Tokoro0917/KOGUMA.MkIIl/README.md

# KOGUMA MkIIl

STM32F446RE(STM32CubeIDE)をベースにしたマイクロマウス(クラシック、迷路探索ロボット)のファームウェア。

- 大会までの予定とやることは`TODO.md`
- 詳しい設計・調べたこと・変更の記録は`docs/`(下の「資料」)

## 目次

1. [動かし方](#動かし方)
2. [大会での流れ](#大会での流れ)
3. [モード](#モード)
4. [出力とビューア](#出力とビューア)
5. [よく変える設定](#よく変える設定)
6. [実機での確認状況](#実機での確認状況)
7. [壁センサ・横壁制御・壁切れ](#壁センサ横壁制御壁切れ)
8. [テストとCI](#テストとci)
9. [ビルド・ハードウェア・ディレクトリ](#ビルドハードウェアディレクトリ)
10. [資料](#資料)

## 動かし方

ロータリーエンコーダの`Encorder_mode_out()`(モード)と`Encorder_number_out()`(ナンバー)の組み合わせで動作を選ぶ。どちらも0〜15。

1. モードとナンバーを選ぶ
2. **左前センサに手をかざす**(`Sensor_Enter()`、FLが1400超)
3. ブザーのあと**左右の横センサに手をかざす**(`Sensor_Start()`、L+Rが2000超)とスタート

走行が終わると`Encorder_count_reset()`でモード0・No.0に戻る。迷路とログはRAMにしか残らないので、**出力するまで電源を切らない**。

## 大会での流れ

1. **会場に着いたら感度合わせ**(モード3 No.5): 区画中心で値を測る → 出た行(`WallDist_Scale`と各しきい値)を書き写す → ビルドし直す(手順は「会場ごとの感度合わせ」)
2. 探索(モード0)
3. 最短走行(モード1)
4. 走らせるたびに、電源を切らずに出力(モード4 No.7)し、ビューアで保存する(迷路とログはRAMにしか残らない。リセットや電源断で消える)

気をつけること:

- `Core/Inc/Define.h`の`MAZE_GOOL_X/Y`は標準ゴール(迷路中央2×2、`MAZE_SIZE/2-1`)。ベンチテストでスタート近くにゴールを置きたいときだけ一時的に書き換え、**書き換えたままコミットしないこと。** 行き止まり潰しのゴール保護もこの定数から導出している。出力(モード4 No.7)の迷路の図の`G`でゴールの位置を確認できる。
- `Move.c`の`Short_Dijkstra_Move2000()`終端の旋回角度(180°→270°)の調整は、手元で作業中ならリポジトリには未反映。
- ゴールは1マス(`MAZE_GOOL_X/Y`、16×16で(7,7))を目指して探索する。標準の中央2×2のゴールなら必ず入れるが、そのマスに行けない迷路では探索の逃げ道がなく、前の壁に向かって進んでしまう(全面探索には「どこにも行けなければスタートへ戻る」逃げ道がある)。

## モード

| モード | 内容 | 番号 |
|---|---|---|
| 0 | **大会用: 探索走行**(往復・片道・全面探索・未知壁探索・探索後の最短) | No.1〜10 |
| 1 | **最短走行**(BFS / ダイクストラ、コーナー2000・2400・ターンごと) | No.1〜11 |
| 2 | サーキット(未実装) | |
| 3 | デバッグ: 固定速度の最短(No.1〜3)、距離の表を作る(No.4)、会場ごとの感度合わせ(No.5)、壁切れのテスト(No.6〜9) | No.1〜9 |
| 4 | 基本調整: センサ表示、直進、旋回、**出力(No.7)**、最初のターンの調整など | No.0〜14 |
| 5〜9 | 速度別のターン単体テスト(1.0 / 2.0 / 2.4 / 2.7 / 3.0 m/s) | No.0〜7 |
| 10 | ターンごとの通過速度のターン単体テスト | No.1〜7 |

表にない番号(モード0 No.0・No.11〜15、モード1 No.0・No.12〜15、モード2、モード3 No.0・No.10〜15、モード4 No.15、モード10 No.0・No.8〜15、モード11〜15など)は何もしない。

### モード0: 大会用(探索走行)

往路(スタート→ゴール)のあと、片道ならゴールで止まり、それ以外はスタートへ戻る。区間の終わりごとに`Maze_Save()`する。No.8〜10はスタートに戻ったあと2秒待って最短走行(モード1 No.5と同じ: ダイクストラ、コーナー2000、直線6000mm/s、加速20000)まで走る。中身は`main.c`の`Maze_Search(flags)`で、番号ごとに`SEARCH_*`の組み合わせを指定している。

| No | 走り方 | 復路 | `SEARCH_*` |
|---|---|---|---|
| 0 | (何もしない) | | |
| 1 | スラローム探索(500mm/s、吸引なし) | 往復 | `SLALOM` |
| 2 | スラローム探索 | 往復、復路で**エセ全面探索** | `SLALOM \| ALL` |
| 3 | スラローム探索 | **片道**(ゴールで止まる) | `SLALOM \| ONEWAY` |
| 4 | 吸引探索(1000mm/s、吸引あり) | 往復 | `SUCTION` |
| 5 | 吸引探索 | 往復、復路で**エセ全面探索** | `SUCTION \| ALL` |
| 6 | 吸引探索 | ゴール後に**ダイクストラ誘導の未知壁探索**、終わったらスタートへ | `SUCTION \| DIJKSTRA` |
| 7 | 吸引探索+**既知区間加速** | No.6と同じ | `SUCTION \| DIJKSTRA \| KNOWN` |
| 8 | スラローム探索 | 往復 → **最短** | `SLALOM \| SHORTEST` |
| 9 | 吸引探索 | 往復 → **最短** | `SUCTION \| SHORTEST` |
| 10 | 吸引探索+**既知区間加速** | No.6と同じ → **最短** | `SUCTION \| DIJKSTRA \| KNOWN \| SHORTEST` |

片道(No.3)はゴール区画に入ったところで、Uターンのときと同じ減速(70mm)で止まる。

既知区間加速(`Robot_Maze_Pass_Action()`)は、次の区画が探索済みなら、未探索の区画の手前までを`Known_Pass_Generation()`でまとめて経路にし、直線を最大4000mm/sで走る。

ダイクストラ誘導(No.6/No.7/No.10)は往路でゴールに着いたあと、スタート→ゴールのダイクストラ経路上に残っている未確認の壁を、今いる位置から直接見に行く(`Maze_Unknown_Wall_Scan()`)。経路の計算は、未確認の壁を「通れる」として行う。計算し直すのは、ゴールに着いた直後、Uターンしたとき、**見に行った壁が実際にあった(経路がふさがれた)とき**だけで、どれも**機体が区画の中央で止まっているあいだに**計算する。ゴールに着いた直後と、壁があったときは、次の区画の中央で止まり、前に壁があれば壁合わせをしてから計算し、進む向きを決めて発進する(`Robot_Maze_Stop_And_Go()`)。Uターンでは止まっているあいだに計算し(`G_Stop_Hook`)、行き止まりでなければ計算した結果で進む向きを決め直す。見に行った壁がなかった(通れた)ときは、ダイクストラは計算し直さず、止まらずに同じ経路で次の未確認の壁を探す。経路上の未知壁がなくなったらスタートへ帰る。このとき、その経路の壁はすべて確認済みなので、それが本当の最短経路になる。

エセ全面探索(`Maze_Unkown_ALL_ModeSet()`)が有効なのは**No.2・No.5だけ**。したがって**行き止まり潰しが走行に影響するのもこの2つだけ**(`Maze_DeadEnd_Fill()`自体は常に計算されるが、結果を使う`Maze_Gool_Setting()`の分岐がALL_MODE時にしか通らないため)。

探索のアルゴリズム(BFS・ダイクストラ、行き止まり潰し)は`docs/maze_algorithm.md`。

### モード1: 最短走行

`Short_*_Move*(MAX, AC)`の`MAX`が直線区間の最高速度、`AC`が加速度。関数名の数字はコーナー通過速度。直線最高速はどれも6000mm/s。中身は`main.c`の`Maze_Shortest_Run()`。斜めの直線の加速度は番号ごとの`ac_nn`(`G_Short_AC_NANAME`)で決める。

| No | 経路生成 | コーナー | 加速度 | 斜めの加速度 | 関数 |
|---|---|---|---|---|---|
| 0 | (何もしない) | | | | |
| 1 | BFS | 2000 | 15000 | 10000 | `Short_NANAME_Move2000` |
| 2 | BFS | 2000 | 20000 | 15000 | `Short_NANAME_Move2000` |
| 3 | BFS | 2400 | 20000 | 15000 | `Short_NANAME_Move2400` |
| 4 | ダイクストラ | 2000 | 15000 | 10000 | `Short_Dijkstra_Move2000` |
| 5 | ダイクストラ | 2000 | 20000 | 15000 | `Short_Dijkstra_Move2000` |
| 6 | ダイクストラ | 2000 | 23000 | 18000 | `Short_Dijkstra_Move2000` |
| 7 | ダイクストラ | 2000 | 25000 | 20000 | `Short_Dijkstra_Move2000` |
| 8 | ダイクストラ | 2400 | 20000 | 15000 | `Short_Dijkstra_Move2400` |
| 9 | ダイクストラ | 2400 | 23000 | 18000 | `Short_Dijkstra_Move2400` |
| 10 | BFS | ターンごと(`docs/turnv_design.md`) | 20000 | 15000 | `Short_NANAME_MoveTurnV` |
| 11 | ダイクストラ | ターンごと(`docs/turnv_design.md`) | 20000 | 15000 | `Short_Dijkstra_MoveTurnV` |

`main.c`の`Short_WallCut_Pillar`を1にすると、最短走行(モード1、モード0 No.8〜10の探索後の最短)の壁切れを柱で見る(「壁切れ」)。既定は0。

No.10・No.11(ターンごとの通過速度)の考え方と速度の決め方は`docs/turnv_design.md`。

No.2とNo.5はパラメータが同一で、BFS経路とダイクストラ経路の比較用になっている。

`Short_Dijkstra_Move2400`は、経路の作り方だけをダイクストラに切り替えて`Short_NANAME_Move2400`と同じ動きで走る(命令列の形はBFSと同じ)。`Short_Dijkstra_Move2000`は旋回のパラメータが`Short_NANAME_Move2000`とは別に調整されている。

コーナー2700(`Short_NANAME_Move2700`)の関数は残してあるが、今はどの番号からも呼んでいない(実機で走れていない)。

### モード3: デバッグ

直線最高速をコーナー速度と同値にして、区間ごとの加減速を実質なくしたもの。

| No | コーナー | 直線最高速 | 加速度 |
|---|---|---|---|
| 1 | 2000 | 2000 | 20000 |
| 2 | 2400 | 2400 | 20000 |
| 3 | 2700 | 2700 | 20000 |
| 4 | 壁センサの距離の表を作る(「距離の表を作り直すとき」) | | |
| 5 | 会場ごとの感度合わせ(区画中心、「会場ごとの感度合わせ」) | | |
| 6〜9 | 壁切れの位置のテスト(500 / 1000 / 2000 / 2400。「壁切れ」、結果は出力 モード4 No.7) | | |

### モード4: 基本調整

| No | 内容 |
|---|---|
| 0 | センサ値・電圧・ジャイロのprintf表示 |
| 1 | 直進テスト(タイヤ径の測定用。吸引70、最大1000・加速度5000で1440mm。2026-10-09 までは吸引35・最大3000・加速度10000) |
| 2 | その場180°旋回テスト |
| 3 | スラロームテスト |
| 4 | 斜め走行テスト |
| 5 | 吸引ON(duty 90)。左前センサに手をかざすと止まる |
| 6 | 壁合わせ |
| 7 | **出力**。RAMに残っているデータを全部出す(迷路、壁切れのログ、走行ログ。下の「出力とビューア」) |
| 8 | 直進テスト(吸引35、最大3000・加速度10000で1440mm)を、横壁制御のセンサ値版(`Kp`/`Kd`)で走る。距離版との比較・切り戻し用 |
| 9 | 最短走行の最初のターンの調整: 右大回り90を1480で(スタート位置から、ターン後は2400へ加速して1区画で止まる) |
| 10 | 同 右斜め入り45を1110で(ターン後は斜めに2区間で止まる) |
| 11 | 同 右斜め入り135を1400で |
| 12〜14 | No.9〜11 と同じターンを、加速しながら曲がる方式で(`G_First_Turn_Accel = 1`) |

### モード5〜9: 速度別のターン単体テスト

モード5=1.0, 6=2.0, 7=2.4, 8=2.7, 9=3.0 m/s。No.1〜7は共通で 1=90°, 2=180°, 3=in45°, 4=in135°, 5=out45°, 6=out135°, 7=V90°。

| モード | No.0 | No.1〜7 |
|---|---|---|
| 5 (1.0m/s) | 90°小回り | 実装済み |
| 6 (2.0m/s) | 直進(吸引51、最大6000・加速度40000で1080mm) | 2000のターン単体(`G_Turn2000`、左旋回、壁切れなし。最短の2000と同じ値) |
| 7 (2.4m/s) | 空 | 実装済み |
| 8 (2.7m/s) | 空 | 実装済み |
| 9 (3.0m/s) | 空 | **No.1のみ実装**、2〜7は空 |

「空」はセンサ待機だけで何も走らせない分岐。

### モード10: ターンごとの通過速度のターン単体テスト

`Short_NANAME_MoveTurnV`の`TurnV_Table`の速度とパラメータで、ターンを1つだけ走る(`Move.c`の`TurnV_Test()`、左旋回)。モード7と同じく壁切れを使わず、前距離・後距離は固定の距離で走る。表の`v`や`offset_st`/`offset_end`を変えたら、ここで1つずつ確かめる。

| No | ターン |
|---|---|
| 1 | 大回り90 |
| 2 | 大回り180 |
| 3 | 斜め入り45 |
| 4 | 斜め入り135 |
| 5 | 斜め出45(斜め入り45で斜めに入り、斜めの直線1区間で表の速度に合わせてから) |
| 6 | 斜め出135(同上) |
| 7 | V90(同上) |

## 出力とビューア

### 出力(モード4 No.7)

RAMに残っているデータを全部、迷路 → 壁切れのログ → 走行ログ の順に出す(ないものは出さない。最後に`#DONE`)。出力のモードはこれひとつ(感度合わせ・距離の表は、そのモードで出し続ける)。

| データ | いつ残るか | 中身 |
|---|---|---|
| 迷路(`MAZE`) | 探索の区間の終わりごと(`Maze_Save()`) | 壁・見た壁、最短走行の命令列(BFS・ダイクストラ)、計算時間。詳しくは`docs/maze_algorithm.md`の「迷路の出力」 |
| 壁切れのログ(`EDGE`) | 最短走行のあいだ、壁切れのテスト(モード3 No.6〜9) | 柱の端、前距離・後距離の始めと終わり、テストでは1mmごとの横センサの値。詳しくは`docs/pillar_cut_design.md`の付録 |
| 走行ログ(`LOG`) | 最短走行(4msおき・8秒、走り始めから)、ターンや直進のテスト(1msおき・2秒) | 走った距離、速度、角速度、角度、横の壁までの距離、横壁制御、横センサ、電圧、電池、動作。詳しくは`docs/log_design.md` |

### ビューア(`tools/viewer.html`)

ロボットのUART出力を、そのままグラフ・表・迷路にするページ。Tera Termはいらない。ネットも使わない(外から何も読み込まないので、会場でも使える)。

1. ロボットをUSBシリアルでつなぎ、`tools/viewer.html`をWindowsのChrome(かEdge)で開く(ダブルクリック)。Tera Termは閉じておく(同じCOMポートは1つしか開けない)
2. 「接続」を押してCOMポートを選ぶ(115200)。届いた文字は下のコンソールに出る
3. 「保存先フォルダ」でリポジトリの`logs/`を選ぶと、届いたデータを1つずつファイル(`日時_種類.txt`)にして自動で保存する。そのファイルをコミットすれば、Claudeは元のデータをそのまま読める
4. ロボットでモード4 No.7(出力)を選ぶと、残っているデータ(迷路・壁切れ・走行ログ)が全部届き、左の一覧に種類ごとに増えて、自動で表示される

| ロボットの出力 | 表示 |
|---|---|
| 走行ログ | 速度・角速度・角度・横の壁までの距離・横壁制御(出力・P項・D項)・誤差・使った壁・横センサ・電圧・電池のグラフ。動作(直線・前距離・ターン・後距離・止まる)で背景を色分けする。横軸は時間か走った距離を選べる。ドラッグで拡大(全部のグラフがそろう)、ダブルクリックか Esc か「拡大を元に戻す」ボタンで元に戻す、指すとその時刻の値と動作。表示している範囲の平均・標準偏差・最小・最大の表(動作で絞れる)。一覧で別のログに印を付けると破線で重ねる |
| 壁切れのテスト(モード3 No.6〜9で走らせたあと) | 横センサの値と距離のグラフ(1mmごと。区画の境目と見つけた柱の端を重ねる。柱のところで値がどう下がるか、`Edge_Min_High`をいくつにするかを見る)。左右・種類ごとの c-border(境目の推定 − 区画の境目)の平均・標準偏差。そのページで読んだテスト全部を速度ごとにまとめた表と、c-border と速度の点のグラフ(左右別)、書き写す`Edge_Off`の行 |
| 最短走行の壁切れ | 柱の端・前距離・後距離・従来の壁切れを距離の軸に並べた図。前距離をどれだけ直したか、どの推定を使ったかの表。後距離が X より早く終わったかの表 |
| 迷路 | 迷路の図(見ていない壁は点線)と、経路の命令列・計算時間 |
| 感度合わせ(モード3 No.5) | 書き写す行(コピーのボタン付き)。測っているあいだ約1秒ごとに届くが、一覧には増やさず、いちばん新しい値に置き換える(5秒あくと新しい測定)。自動では保存しない(残したいときは「ファイルに保存」) |
| センサの値(モード4 No.0、モード3 No.4) | 一覧のいちばん上の「センサの値(そのまま)」。直近10秒を流れるグラフ(FL・L・R・FR、モード4 No.0は電池と角速度、モード3 No.4は表で変換した距離も)と、今の値。「止める」で止めて見られる。直近60秒をCSVで保存できる。モード4 No.0の値は10回の移動平均(`g_sensor_av10`)なので、1回だけの落ち込みは見えにくい |

- 保存したファイルや、Tera Termのログは「ファイルを開く」かドラッグで読み込める(`tools/sample_output.txt`はロボットなしで見た目を確かめる用の例)
- 「ぜんぶ保存」は、ページを開いてから届いた文字を1つのファイルにする(長くなったら最後の約10MB、約14分ぶんだけ)
- 出力の形: どれも`#BEGIN 種類 項目=値 ...`で始まり`#END 種類`で終わる(`LOG`・`EDGE`・`MAZE`・`CENTER`)。`LOG`は次の行が列名なので、列を増やしてもビューアは直さなくてよい
- ダブルクリックで開いた(`file://`)ままで、USBシリアルもフォルダへの保存も使える(Chromiumで確かめた)。もし使えなければ、`tools`で`python -m http.server`を実行して`http://localhost:8000/viewer.html`を開く

## よく変える設定

| 設定 | 場所 | 今の値 | 内容 |
|---|---|---|---|
| `Short_WallCut_Pillar` | `main.c` | 0 | 1で、最短走行の壁切れを柱で見る(「壁切れ」) |
| `ac_nn` | `main.c`(モード1の番号ごと) | 上の表 | 最短走行の斜めの直線の加速度(0なら直線の加速度-5000) |
| `G_WallCtrl_Use_mm` | `Wallsensor.c` | 1 | 横壁制御。1=距離版、0=センサ値版 |
| `Kp_mm` / `Kd_mm` | `Wallsensor.c` | 0.30 / 0.06 | 距離版の横壁制御のゲイン(センサ値版の`Kp`=0.05 / `Kd`=0.01と同じ効き) |
| `WallDist_Scale` | `WallDistance.c` | 0.99, 0.96, 1.00, 1.02 | 会場ごとの倍率(FL, R, L, FR)。モード3 No.5で測る |
| `Cut_L` / `Cut_R`(`_NA`) | `motor.c` | 80(斜めは150) | 壁切れの閾値 |
| `G_WallCut_Fast` | `motor.c` | 0 | 1で、壁ありの壁切れを遅れの少ない値(3回の中央値)で見る。壁切れの位置が変わるので前距離・後距離を合わせ直す |
| 柱の壁切れの値: `Edge_Off` / `Edge_Tan` / `Edge_Win` | `Wallsensor.c` / `motor.c` | 84 / 1.07 / 20 | 柱の端から境目までの距離(左右・種類ごと)、横のずれの補正、前距離で推定を探す範囲。モード3 No.6〜9で実測して直す |
| `TIREDIAMETER` | `Define.h` | 23.1 | タイヤ径[mm]。モード4 No.1で測る |
| `G_Turn2000` | `Move.c` | | 2000のターンの前距離・角度・角速度・角加速度・後距離(モード6で調整) |
| `TurnV_Table` | `Move.c` | | ターンごとの通過速度(モード10で調整) |
| `G_First_Turn` / `G_First_Turn_Accel` | `Move.c` | / 0 | 最短の最初のターンの値と、加速しながら曲がる方式を使うか(モード4 No.9〜14) |
| `KNOWN_PASS_BIG_TURN` | `Maze.c` | 0 | 探索の既知区間加速で大回りを使うか |
| `G_Log_Div` | `LOG.c` | 1(最短は4) | 走行ログを何msおきに取るか(`main.c`の最短走行で4にする) |
| `MAZE_SIZE` | `Define.h` | 16 | 迷路のサイズ(16 / 32。32はRAMが足りない、`docs/maze_algorithm.md`) |

## 実機での確認状況

2026-10-12時点。2026-10-08 以降の変更の多くは、実機で未確認。

| 項目 | 結果 |
|---|---|
| STM32CubeIDEでのビルド | 2026-10-07 まで OK。それ以降(モード1 No.10・No.11、モード10、柱の壁切れ、ビューア向けの出力)は未確認。ARMのgccではビルドとリンクが通る |
| モード4 No.0(センサ・電圧・ジャイロ) | OK |
| モード0 No.1〜10 | OK(2026-10-06)。No.4はゴール後のUターンで急に前進していたが、Uターンの位置合わせの修正後にOK |
| モード1 No.1〜9 | OK(2026-10-07)。2026-10-09 にダイクストラ2000のターンの値・2000の走り出し・タイヤ径を変えたあとは未確認 |
| 最短走行の走り出し(最初がターン) | 2026-10-08 に最初のターン3つを調整し(モード4 No.9〜11)、2000・2400とも走ることを確認 |
| 横壁制御の距離版(既定) | 探索・最短走行とも問題なし(2026-10-07)。2026-10-10 のゲイン・判定の変更のあとは未確認 |
| 迷路の出力 | OK(以前のモード3 No.0。PCでも同じ命令列になり壁に当たらない)。モード4 No.7 にまとめたあとは未確認 |
| モード3 No.5(会場ごとの感度合わせ) | OK。測った倍率を`WallDist_Scale`に入れた |
| モード1 No.10・No.11、モード10(ターンごとの通過速度) | 未確認 |
| モード3 No.4(距離の表) | 未確認 |
| 柱の壁切れ、モード3 No.6〜9、出力(モード4 No.7)、ビューア | 未確認(2026-10-12 に追加) |

## 壁センサ・横壁制御・壁切れ

### 壁センサの距離変換(`Core/Src/WallDistance.c`)

壁センサの値は距離に比例しない(近いほど急に大きくなる)。センサ値の差をそのまま制御に使うと、壁に近いときはゲインが効きすぎ、遠いときは効かなくなる。また左右のセンサで感度が違うため、`(L - 220) - (R - 200)`は単位の違う数どうしの引き算になる。`WallDist_mm(sensor, value)`はセンサ値を距離[mm]に変換する(表引き+直線補間)。

距離の定義: 横センサは機体の中心線から横壁の表面まで、前センサは機体の中心から前壁の表面まで。区画中心ではどちらも84mm。

**横(L/R)は実測値**(2026-10-06)。機体の側面を反対側の壁につけ、壁の板(12mm)を n 枚はさんで、測る側の壁までを 133 − 12n mm(n = 0〜8、37〜133mm)にして測った(区画の内のり168mm、機体の幅70mm)。区画中心付近(85mm)で L=237、R=201。**前(FL/FR)も実測値**。お尻を後ろの壁につけ、板を n 枚はさんで前の壁までを 108 − 12n mm(n = -8〜4、60〜204mm。n が負はお尻を後ろの壁から離した)にして測った(全長120mm、中心からお尻まで60mm)。区画中心(84mm)で FL=645、FR=627。60mmより近い点はまだ測っていない(表の範囲外は端の値になる)。

#### 距離の表を作り直すとき(モード3 No.4)

1. モード3 No.4を選び、前センサに手をかざしてから横センサに手をかざしてスタートする
2. 約0.2秒ごとに`CAL,FL,L,R,FR,FL_mm,L_mm,R_mm,FR_mm`の形式でシリアル出力される(センサ値は100回平均、`_mm`は現在の表で変換した距離)
3. 横センサ: 機体を横にずらし、壁までの距離を44, 54, …, 124mmに合わせてL/Rの値を記録する
4. 前センサ: 前壁までの距離を34, 44, …, 174mmに合わせてFL/FRの値を記録する
5. `WallDistance.c`の表に書き写し、`test/test_walldist.c`を実行して表の並びが正しいか確認する
6. もう一度モード3 No.4で、`_mm`の列が実際の距離と一致するか確認する

手で機体を動かすとエンコーダのモード選択が変わるが、キャリブレーション中はループの中にいるので影響しない。終了はリセット。

#### 会場ごとの感度合わせ(モード3 No.5)

会場では壁の反射の強さ(塗装)が変わり、センサ値が全部の距離でほぼ同じ割合で変わる。表は作り直さず、区画中心で1回測った倍率で合わせる。

1. モード3 No.5を選び、前センサに手をかざしてから横センサに手をかざしてスタートする
2. 機体を区画中心に置き、前・左・右に壁がある状態にする(スタート区画なら、後ろの壁のほうを向けて置く)
3. 約1秒ごとに、500回平均した値と、書き写す行がシリアルに出る
   - `WallDistance.c`の`WallDist_Scale`(倍率 = 測った値 / 表の区画中心の値。距離変換はセンサ値をこれで割ってから表を引く)
   - `Wallsensor.c`の`Wall_L`/`Wall_R`/`FlontWall_Distance`(区画中心の値そのもの)と`Wall_threshold`
   - `Move.c`の`ALIGN_FRONT_MIN`、`motor.c`の`Cut_R`/`Cut_L`/`Cut_R_NA`/`Cut_L_NA`
4. 出た行を手で書き写してビルドし直す。終了はリセット

閾値は「倍率1のときの値 × 倍率」で出す。基準の値は`Wall_Center_Calibration()`の中にある(2回目以降も、書き写したあとの値ではなく基準の値に掛ける)。閾値の基準を変えたら、ここも直す。

### 横壁制御(`Wallsensor.c`、`G_WallCtrl_Use_mm`)

`Wallsensor.c`の`G_WallCtrl_Use_mm`を1にすると、横壁制御(`Wall_Control_Update()`、1msに1回)の誤差を`(84 - 距離)`[mm]で計算する。2026-10-07から既定は1。0に戻すと従来のセンサ値版(`センサ値 - Wall_L/Wall_R`)になる。モード4 No.8はこの走行のあいだだけセンサ値版で走る。

距離版の中身:

- 横センサは直近3回の中央値を使う(1回だけの落ち込みを消す)
- 壁まで`WallCtrl_mm_MaxDist`(120mm)以内の壁だけを使う
- 片側の誤差を±`WallCtrl_mm_ErrMax`(20mm)で頭打ちにする。片側の壁だけのときは誤差を2倍にする
- `WallCtrl_mm_StableLen`(10mm)進む間に距離が`WallCtrl_mm_StableTH`(15mm)以上変わった壁は、壁の見え始め・消えかけとして使わない(何ms前と比べるかは速度から決める)
- ゲイン`Kp_mm`/`Kd_mm`(0.30 / 0.06)は、区画中心付近(約6[値/mm])でセンサ値版の`Kp`/`Kd`(0.05 / 0.01)と同じ効き。センサ値版は壁から離れると効きが弱くなるが、距離版は弱くならない
- ゲインは速度/500倍(2000以上は4倍)。下限`WallCtrl_mm_GainMin`は今は0(下限なし)
- 壁の有無が切り替わった瞬間はD項を出さない

ほかの人のやり方との比較は`docs/wall_research.md`。

### 壁切れ(`motor.c`)

ターンの前後の直線(前距離・後距離)を、横の壁や柱を基準にして合わせる。`main.c`の`Short_WallCut_Pillar`(既定0)で、最短走行の間だけ方法を切り替える(`G_WallCut_Pillar`)。探索中と斜めの壁切れ(`Cut_L_NA`/`Cut_R_NA`、150)はいつも従来どおり。

**従来**(`Short_WallCut_Pillar` = 0)。横センサ(`g_sensor_av`)が`Cut_L`/`Cut_R`(80)を下回ったところを壁の終わりとみなす。
- 前距離: Xの半分まで走り、曲がる側に壁があれば下回るまで待ってから、残りX/2を走る
- 後距離: 壁があった側が下回ったら終わる。Xは最大
- `g_sensor_av`は5回の移動平均で約2ms遅れ、反応する位置が速度×2ms後ろにずれる(1000で2mm、2400で4.8mm)。`G_WallCut_Fast`を1にすると3回の中央値(遅れ約1ms)で判定する(斜めも)。既定は0。1にすると壁切れの位置が変わるので、前距離・後距離を合わせ直す

**柱**(`Short_WallCut_Pillar` = 1、2026-10-12、設計は`docs/pillar_cut_design.md`)。今後はこちらに一本化する(斜めは決まっていないことが多いので、いまは従来どおり)。
- 横センサは区画中心で柱の真ん中を見る向き(真横から約47°)なので、柱の後ろの端は、機体の中心が境目より約84mm手前のときに見える
- センサ値ができるたび(DMA割り込み、`pl_callback_getSensor`)に`Wall_Edge_Sample()`が、その時点の走行距離(`G_Odo_X`、動作ごとに0に戻らない)といっしょに左右の値(3回の中央値)を1mmごとの履歴(`DistHist.c`)に残す。中央値とLPFの遅れ(`Edge_Lag_S` = 1.2ms)の分は距離を戻す
- **下がる端**(壁の終わりも、柱だけの山も): 直前30mm(`Edge_High_Len`)の最大値の半分を切った位置(`PillarEdge.c`)。会場の明るさや壁との距離で信号の大きさが変わっても、位置はほとんど変わらない。PCのモデルでは、速度300〜3000・信号の大きさ0.6〜1.4倍で位置のばらつきが約0.2mm(従来の閾値80では16.5mm)
- **境目の推定** c = 端の位置 + `Edge_Off`(既定84、左右・種類ごと、モード3 No.6〜9で実測して直す)+ 横のずれの補正 `(壁までの距離 − 84) × Edge_Tan`(1.07)。壁までの距離はその側の壁、なければ反対側の壁から求める
- 角速度が150deg/s(`Edge_Max_W`)を超えたら(ターン中など)履歴を空にし、それより前の推定は使わない
- 前距離: 前距離の始め(区画中心)から X で曲がり始めるのを、境目の実測で直す。前の境目(区画中心+90 ± `Edge_Win` 20mm)の推定があれば「境目 + X − 90」、なければ後ろの境目(区画中心−90)で「境目 + 90 + X」、どちらもなければ距離だけ。左右の両方に推定があれば平均する(向きのずれ1°で約3mmが左右で逆に出るので打ち消される)
- 後距離: Xだけ走る(ターンのあと、次の境目の柱はターンの終わりのすぐ後に見えるので後距離では使えない。その境目は次の前距離で使う)
- 上がる端(手前に壁がなく先に壁がある所)はまだ使わない(設計の段階2)

壁切れのテスト(モード3 No.6〜9)の走らせ方と、壁切れのログの形は`docs/pillar_cut_design.md`の付録。

## テストとCI

ホスト(PC)のgccで、HALに依存しない部分を確かめる。CI(`.github/workflows/maze-test.yml`)が master への push と PR のときに全部実行する。ファームウェア本体のARMビルドはCIの対象外。何を確かめているかは`docs/testing.md`。

| テスト | 対象 | 実行 |
|---|---|---|
| `test/test_deadend.c` | 行き止まり潰し(16×16 と 32×32) | `gcc -std=c11 -Wall -I Core/Inc -o test_deadend test/test_deadend.c Core/Src/Maze.c && ./test_deadend`(32×32は`-DMAZE_SIZE=32`) |
| `test/test_shortpath.c` | 最短走行の命令列(16×16 と 32×32)、実機の迷路の出力の確認(`--dump`) | `gcc -std=c11 -Wall -I Core/Inc -o test_shortpath test/test_shortpath.c Core/Src/Maze.c && ./test_shortpath` |
| `test/test_walldist.c` | 壁センサの距離変換の表 | `gcc -std=c11 -Wall -I Core/Inc -o test_walldist test/test_walldist.c Core/Src/WallDistance.c && ./test_walldist` |
| `test/test_speedplan.c` | ターンごとの通過速度の速度計画 | `gcc -std=c11 -Wall -I Core/Inc -o test_speedplan test/test_speedplan.c Core/Src/SpeedPlan.c -lm && ./test_speedplan` |
| `test/test_disthist.c` | 距離ごとのセンサ値の履歴 | `gcc -std=c11 -Wall -I Core/Inc -o test_disthist test/test_disthist.c Core/Src/DistHist.c -lm && ./test_disthist` |
| `test/test_pillaredge.c` | 柱の端の検出 | `gcc -std=c11 -Wall -I Core/Inc -o test_pillaredge test/test_pillaredge.c Core/Src/PillarEdge.c Core/Src/DistHist.c -lm && ./test_pillaredge` |

## ビルド・ハードウェア・ディレクトリ

- MCU: STM32F446RE(Cortex-M4, Flash 512KB, RAM 128KB)。今のビルドで RAM 約115KB / Flash 約129KB(Debug、-O0)
- 開発環境: STM32CubeIDE 1.14.0。本フォルダをワークスペースにインポートしてビルドする

```
Core/Src, Core/Inc   本体ファームウェア
Drivers/             STM32 HAL / CMSIS
KOGUMA.MkII/          旧バージョン一式(参考用に同梱)
test/                ホスト(PC)上で走るテスト(迷路・距離変換・速度計画・距離ごとの履歴・柱の端)
tools/               ビューア(UART出力をグラフ・表・迷路にする)
logs/                ビューアで保存したロボットの出力
sim/                 PC上の探索シミュレータとブラウザ用の可視化
docs/                調べたことのメモ(他の人のターン速度の決め方、壁制御・壁切れのやり方など)
.github/workflows/   CI設定
*.ioc                STM32CubeMX設定
STM32F446RETX_*.ld   リンカスクリプト
```

`Debug/`(ビルド成果物)とホストテストの実行ファイルは`.gitignore`で除外している。

## 資料

| ファイル | 中身 |
|---|---|
| `TODO.md` | 大会までの予定とやること |
| `docs/changelog.md` | 変更の記録(以前の README の「直近の主な変更」) |
| `docs/pillar_cut_design.md` | 柱の壁切れの設計、テストとログの形 |
| `docs/log_design.md` | 走行ログの列の決め方 |
| `docs/wall_research.md` | 壁制御・壁切れのほかの人のやり方 |
| `docs/maze_algorithm.md` | 迷路探索(BFS・ダイクストラ・行き止まり潰し・迷路サイズ)、迷路の出力とPCでの確認 |
| `docs/turnv_design.md` | ターンごとの通過速度(モード1 No.10・No.11) |
| `docs/turn_speed_research.md` | ほかの人のターン速度の決め方 |
| `docs/testing.md` | テストが確かめていること |
