Tokoro0917/KOGUMA.MkIIl/mechanical/KOGUMA.MK3_全体v2.step

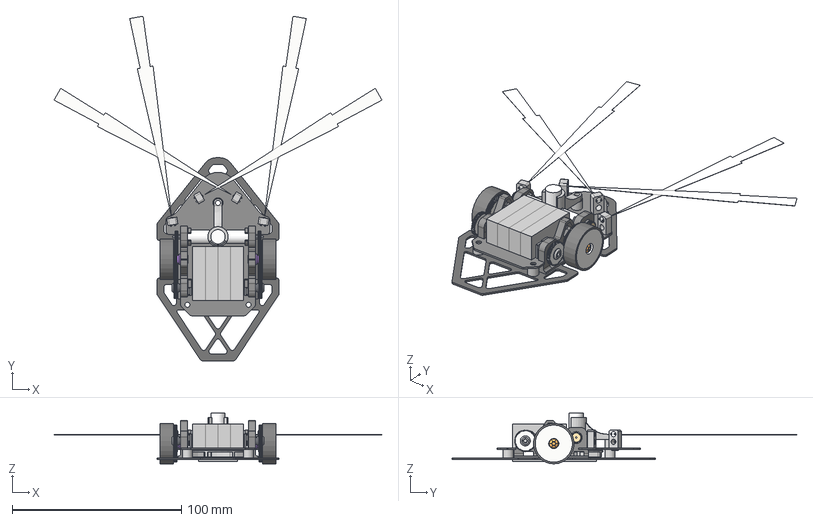
[picture p1: CAD file, 2026-10-17]
mechanical/KOGUMA.MK3_全体v2.step
193.8 x 203.6 x 30.0 mm
ナイロンナットM3 パープル v2
モーターマウントv2
コンポーネント1
ベアリング（D６ｄ３） x 2
アルミテーパーM3 x 2
92855A846_18-8 Stainless Steel Low-Profile Socket Head Screws
Spur Gear (71 teeth)
LF-630_ir x 2
LF-630_cage x 2
LF-630_ball x 16
LF-630_or x 2
3mm磁石
3*6平行ピン
エンコーダギアマウント
Spur Gear (41 teeth)
NFP-D0816S
Spur Gear (20 teeth)
TSSOP14_OSM
ナイロンナットM3 パープル v2(ミラー)
モーターマウントv2 v3(ミラー)
Component1(ミラー)
ベアリング（D６ｄ３） v2(ミラー) x 2
アルミテーパーM3 v3(ミラー) x 2
92855A846_18-8 Stainless Steel Low-Profile Socket Head Screws(ミラー)
Spur Gear (71 teeth)(ミラー)
LF-630_ir_1 x 2
LF-630_cage_1 x 2
LF-630_ball_1 x 16
LF-630_or_1 x 2
3mm磁石 v1(ミラー)
3*6平行ピン v2(ミラー)
エンコーダギアマウント v9(ミラー)
Spur Gear (41 teeth)(ミラー)
NFP-D0816S v2(ミラー)
Spur Gear (20 teeth)(ミラー)
TSSOP14_OSM v1(ミラー)
底板v2
M3*5mmスペーサー x 4
基板2 v12
8520ファン用モーターマウント
吸引モータ
吸引ファンΦ30内径1mm v7
吸引モーター抑え
Lipo 180mAh[ x 4
一次スカート
Φ3弾丸型LED v2 v1 x 4
センサホルダ x 4
