Tokoro0917/KOGUMA.MkIIl/(list of files, cad)

Other CAD files:
mechanical/KOGUMA.MK3.f3z
