Tokoro0917/KOGUMA.MkIIl/docs/changelog.md

# 変更の記録

README の「直近の主な変更」をここに移した(2026-10-12)。新しいものが上。コミットの履歴(`git log`)も見る。

## 2026-10-12
- ビューア: 拡大しているあいだだけ「拡大を元に戻す」ボタンを出す(走行ログ、壁切れのテストのセンサ値、最短走行の壁切れの図)。Esc キーでも戻す(ダブルクリックも今までどおり)
- ビューア: センサの値を出し続けるモードに対応した。感度合わせ(モード3 No.5)は1秒ごとに一覧とファイルが増え続けていたので、続けて届いたらいちばん新しい値に置き換え、自動では保存しないようにした。センサ表示(モード4 No.0)と距離の表(モード3 No.4)の行を読み取り、直近10秒を流れるグラフにする「センサの値(そのまま)」を足した。「ぜんぶ保存」用に覚えておく文字に上限(最後の約10MB)を付けた
- ビューアを速くした。グラフを指したときに全部のグラフを描き直していたのを、本体を取っておいて縦線だけ重ねるようにした(1回 約4ms → 約0.3ms、走行ログ2000行×10枚)。受け取った文字を行に分けるときに毎回残りを作り直していたのをやめ、ファイルの読み込みや出力が続けて届いたときは最後に1回だけ描く(約0.9MBの読み込み 188ms → 約10ms、シリアル 151ms → 約23ms)
- READMEを整理した。使い方(動かし方、大会での流れ、モード、出力とビューア、設定、確認状況)を中心にし、詳しい設計とテストの中身、変更の記録を`docs/`に移した(`changelog.md`、`maze_algorithm.md`、`turnv_design.md`、`testing.md`、`pillar_cut_design.md`の付録)。なくしたモード4 No.15の記述、古いRAMの数字、実機での確認状況を今に合わせた
- 従来の壁切れの前距離も、壁切れのログに前距離の始めと曲がり始め(`st` / `st_cut`)を残すようにした。ビューアの前距離の表が従来のときも埋まる(直した量 = 曲がり始め − (区画中心 + X))
- `Motor_Wallcut_ST`で、走行ログの動作(`phase`)を「前距離」にするのが柱のときだけになっていたのを直した(従来のときは前の動作のままだった)
- **柱の壁切れを作り直した**(設計は`docs/pillar_cut_design.md`。`Short_WallCut_Pillar` = 1 のときだけ。既定は0で、ふだんの走行は変わらない)。今後は柱に一本化する(斜めはいまは従来どおり)
  - 横センサは区画中心で柱の真ん中を見る向き(約47°)なので、柱の端は境目の約84mm手前で見える。ターンは区画中心から始まるので、前の境目の柱の端は前距離の始めの少し先で見え、従来の「Xの半分から待つ」では短い前距離(2400で3〜25mm)のときに見逃していたはず
  - センサ値ができた時点(DMA割り込み)の走行距離といっしょに、左右の値を1mmごとに残す(TIM6の中で読む値は約1ms前のものだった)
  - 下がる端を「直前30mmの最大値の半分を切った位置」で見つける(`PillarEdge.c`)。会場の明るさや壁との距離に左右されにくい
  - 端から境目を推定し(`Edge_Off`、横のずれの補正 `Edge_Tan`)、前距離の曲がり始めを直す。左右にあれば平均する。後距離は距離だけ
  - 午前に作った「5mm進む間に40以上減ったら」の判定(`Pillar_Edge`、`G_Pillar_DistHist`、`Pillar_TH`、`Pillar_Len`、`Pillar_MaxX`)はなくした
- 壁ありの壁切れを遅れの少ない値(3回の中央値)で見るスイッチ`G_WallCut_Fast`を追加(`motor.c`、既定0で従来どおり)
- 壁切れの位置のテストをモード3 No.6〜9に、最短走行の壁切れのログをモード4 No.15に追加。テストでは横センサの値(3回の中央値)も1mmごとに残して出す(`sig`の行、最大1000mm。RAMは約123KB/128KB)
- `test/test_disthist.c`・`test/test_pillaredge.c`を追加し、CIで実行する
- ARMのgcc(arm-none-eabi-gcc 13.2、-O0)で全体のビルドとリンクが通ることを確認(新しい警告なし。RAMは約119KB/128KB)。STM32CubeIDEでは未確認
- 壁制御と壁切れのほかの人のやり方を`docs/wall_research.md`にまとめた
- **出力をモード4 No.7のひとつにまとめた**。迷路(以前はモード3 No.0)、壁切れのログ(以前はモード4 No.15、テストは走ったあとすぐ出していた)、走行ログを、残っているものだけ順に出す
- **走行ログを選び直した**(`docs/log_design.md`)。列は 走った距離・速度・角速度・角度・横の壁までの距離・使った壁・横壁の誤差とP項・D項・横センサ・電圧・電池・動作。int16で持ってRAMを約8KB減らした(約115KB/128KB)。普段は1msおき(2秒)、最短走行は4msおき(8秒、`G_Log_Div`)で、最短走行では走り始めから取る
- **ビューア`tools/viewer.html`を追加**(README の「ビューア」)。ロボットの出力の形をそろえた(走行ログ・壁切れ・迷路・感度合わせを`#BEGIN`/`#END`ではさむ。走行ログは取った行数だけ出し、数字の桁を減らして約半分の時間で出る)

## 2026-10-11
- READMEを整理した。モード選択(選び方・モード一覧・各モード)を先頭にまとめ、よく変える設定の表と、壁切れ(柱)の説明を足した。モード6 No.0(直進)、モード4 No.5・No.8、モード1の斜めの加速度、横壁制御の距離版の説明を今のコードに合わせた

## 2026-10-10
- **距離版の横壁制御で、横センサの直近3回の中央値を使うようにした**(`Wallsensor.c`の`Wall_Sensor_Median3()`)。モード4 No.1のログで、左センサだけ4msおきに1回だけ落ち込み、そのたびに`Wall_error`が-20〜-33に飛んで左へ寄せる向きに偏っていた。センサ値の履歴は`g_sensor[i][1]`が更新直後のずらしで`[0]`と同じ値になるので、`[0]`・`[2]`・`[3]`の中央値にした
- **最短走行の斜めの直線の加速度を変えられるようにした**(`G_Short_AC_NANAME`)。モード1は`main.c`の番号ごとの`ac_nn`で決める(2000・2400・ターンごとは直線の加速度-5000。2400・ターンごとは以前は-10000だった)。0にすると既定値(-5000、2700だけ-10000)。モード0の探索後の最短とモード3は既定値のまま
- **ダイクストラ2000(モード1 No.4〜7、モード0 No.8〜10の最短)の区画の直線を、BFSと同じ`Motor_trapezoid_Asymmetric_PID`(減速は加速の2倍)にした**。以前は`Motor_trapezoid_PID`(加速と減速が同じ)。No.6(加速23000)・No.7(25000)は減速が46000・50000になる
- 距離版の横壁制御の切れ目判定が効くようにした(`Wallsensor.c`)。今までの`Sensor_diff_L/R`は`g_sensor[i][0] - g_sensor[i][1]`で、`[1]`はずらし後に`[0]`と同じ値なので常に0だった。距離版では、壁までの距離を1msごとに残し、`WallCtrl_mm_StableLen`(10mm)進む前(速度から何ms前かを決める)と比べて`WallCtrl_mm_StableTH`(8mm)以上変わった壁は使わない。壁の見え始め・消えかけはセンサ値が20mmほどかけて変わり、その途中で壁を遠いと読んで誤差が±20に張り付き、ジャイロが40〜60deg/s振れていた。1msの変化で見る方法は速度で効き方が変わり、1000mm/sでは一度も効かなかった。センサ値版(`G_WallCtrl_Use_mm = 0`)の判定は変えていない
- 距離版の横壁制御のゲイン倍率(速度/500)に下限`WallCtrl_mm_GainMin`(0.5)を付けた(目標速度が0より大きいときだけ)。減速中に倍率が小さくなって効かず、止まるまでに10mm以上片寄っていた
- 距離版の横壁制御を、センサ値版(`G_WallCtrl_Use_mm = 0`)と同じ強さにした。センサ値版のほうがふらつきが少なかったため。`Kp_mm` 0.35→0.30・`Kd_mm` 0.07→0.06(区画中心付近は約6[値/mm]なので、センサ値版の`Kp`=0.05・`Kd`=0.01と同じ効き)、`WallCtrl_mm_StableTH` 8→15mm(左センサのノイズで壁を使う/使わないが数msおきに切り替わっていた。ノイズが直れば8に戻す)、`WallCtrl_mm_GainMin` 0.5→0(センサ値版と比べるため下限なし)
- **壁切れを柱で見られるようにした**(`motor.c`の`G_WallCut_Pillar`、`Wallsensor.c`の`Pillar_Edge()`)。`main.c`の`Short_WallCut_Pillar`を1にすると、最短走行(モード1、モード0 No.8〜10の探索後の最短)の間だけ有効になる(既定は0で従来どおり。探索中はいつも従来どおり)。壁があるときは従来どおり(センサ値が`Cut_L`/`Cut_R`を下回ったら)。壁がないときは、横センサの値が`Pillar_Len`(5mm)進む間に`Pillar_TH`(40)以上減ったら柱の後ろの端とみなして壁切れする(壁の有無は待ち始めの時点の`G_Wall_data`で決める)。区画の境目には必ず柱があるので、壁のない所でも壁切れできる。斜めの壁切れ(`Cut_L_NA`/`Cut_R_NA`を使うもの)は柱版でも従来どおり。1回だけの飛びで誤判定しないよう3回の中央値どうしで比べ、ターン直後の9msは見ない。柱が見つからないときは、前距離では残りの半分(`X`の半分)、後距離では`Pillar_MaxX`(140mm)進んだら諦める。壁がある所は従来と同じ位置で反応するので、前距離・後距離はそのまま使える。柱だけの所は従来の閾値を下回る位置より少し手前で反応する
- `WallDist_Scale`の R・L を 1.07・0.95 から 0.96・1.00 にした(`WallDistance.c`)。区画中心でモード3 No.4 が L=242→82.0mm、R=198→89.5mm で、左右で7.5mm食い違っていた
- `WallCtrl_mm_MaxDist`を104から120にした。104では中心から20mmほど片寄ったときに壁を使う/使わないが切り替わり続け、中心に戻れなかった

## 2026-10-09
- **距離版の横壁制御の微分ゲイン`Kd_mm`を0.05から0.07にした**。吸引探索のターンのテスト(モード5 No.0)のログで、ターンそのものは約89.6°で合っていたが、横壁制御で左右に数mm揺れながら走っていて、ターンに入るときの向きが約2°ずれていた。区画中心での左右の距離(85.0 / 83.3mm)は合っていた
- **探索の既知区間加速で大回りを使わないようにした**(`Maze.c`の`KNOWN_PASS_BIG_TURN` = 0)。既知区間の曲がりは、すべて探索と同じ小回りスラローム(1000)で走る。直線の加速(最大4000)はそのまま。1にすると以前どおり直線にはさまれた曲がりを大回り90/180にする
- **モード6の斜め出45・斜め出135・V90(No.5〜7)を斜めスタートに戻した**(2026-10-09)。表にまとめたとき、斜め入り45で斜めに入ってから曲がる形にしてしまっていた。機体を斜めに置き、斜め1区間(127.3mm、加速度25000)で2000まで上げて前距離→ターン(左)→後距離
- **2000のターンの値を1つの表(`Move.c`の`G_Turn2000`)にまとめた**。以前はBFS(`Short_NANAME_Move2000`)・ダイクストラ(`Short_Dijkstra_Move2000`)・モード6に別々に書かれていて、ダイクストラだけ値が違っていた。BFS(=モード6)の値にそろえたので、**ダイクストラ2000(モード1 No.4〜7、モード0 No.8〜10の最短)のターンが変わる**。モード6 No.1〜7は`Turn2000_Test()`で表の値を走る(左旋回。斜め出45・135・V90は機体を斜めに置いてスタート)。直線の走り方(BFSは減速が2倍の`Motor_trapezoid_Asymmetric_PID`、ダイクストラは`Motor_trapezoid_PID`)はそのまま
  - 以前のダイクストラ2000の値(前距離 / 角度 / 最大角速度 / 角加速度 / 後距離): 大回り90 15/88.5/1200/30000/35、大回り180 30/178/1280/30000/60、斜め入り45 8/43/1600/55000/55、斜め入り135 10/134/1300/50000/9、斜め出45 22/42/1500/40000/21、斜め出135 8/131.5/1700/50000/70、V90 7/84/2000/80000/35
- **タイヤ径`TIREDIAMETER`を実測の23.1mmにした**(23.5から。モード4 No.1で測定)。実際の速度と走る距離が約1.7%増える
- **モード4 No.1(直進テスト)をタイヤ径の測定用にした**。吸引70で、最大1000・加速度5000でゆっくり1440mm走る。実際に進んだ距離を測り、`Define.h`の`TIREDIAMETER` = 今の値 × 実際の距離 / 1440 にする。横壁制御の揺れを見る速い直進は No.8(センサ値版)か、No.1を一時的に戻して見る
- **距離版の横壁制御の比例ゲイン`Kp_mm`を0.26から0.35にした**(`Wallsensor.c`)。区画中心では従来のセンサ値版と同じ効きだが、センサ値版は壁に寄るほど強く効いていた(傾きが寄るほど大きい)のに対し、距離版は一定で、片側±20mmの頭打ちもあるため、寄ったときの戻りが弱かった。`Kd_mm`(0.05)はそのまま。中心付近の小さな揺れが増えないか、モード4 No.1のログで見る
- **2000(モード1 No.1〜7、モード0 No.8〜10の最短)は、最初のターン専用の動きを使わないように戻した**(`Move.c`の`Short_Start_NoFirstTurn()`)。最初がターンなら10mmで2000にしてから、いつもの2000のターンを走る(以前と同じ)。吸引も50のまま。最初が直線なら今までどおり114mmでなめらかに加速する。最初のターン専用の動き(`G_First_Turn`、吸引70への切り替え、加速しながら曲がる方式)は2400・2700・1000・ターンごとの通過速度で使う
- **加速しながら曲がる最初のターンを追加**(`motor.c`の`Motor_First_Turn_Accel()`、`Move.c`の`G_First_Turn_Accel`。既定は0で今までどおり、モード4 No.12〜14で試せる)。スタートから後距離の終わりまで、目標速度を0から1本のcos加速(`SHORT_FIRST_TURN_AC` = 20000)で上げ続ける。ターン中も加速するので、角度は時間ではなく走った距離で決める(`G_First_Turn`の速度で走ったときの曲率 × 今の速度を目標角速度にする)。速度に関係なく、今合わせた軌跡(前距離・角度・後距離)を通る
  - 後距離の終わりの速度(計算、上限2400): 大回り90・斜め入り135は2400、斜め入り45は約2300。今までの方式は約2180 / 1970 / 1860で、2400まで上がらず次の区間で目標速度が跳んでいた
  - 加速度20000は電圧が張り付く手前(25000では張り付いていた)。ターン中の最大横Gは計算で約77m/s²(大回り90)、約79(斜め入り135)、約47(斜め入り45)。2400の斜め入り135(約84)と同じくらい
  - 全体の距離の9割で上がりきるように上限を決める(`SHORT_FIRST_TURN_MARGIN`、後距離が壁切れで早く終わる分の余裕)

## 2026-10-08
- **最初のターンの加速度`SHORT_FIRST_AC`を50000から25000にした**。50000のときのログ(モード4 No.9)では、加速中は左右とも電圧が上限(200)に張り付き、実際の加速度は約25000〜28000だった。前距離が短い斜め入りでは、目標の速度にまだ届いていないのにその速度の角速度で曲がっていた
  - ターンの速度を24mm+前距離で届く値にした(大回り90 1480、斜め入り45 1110、斜め入り135 1400。角速度×k・角加速度×k²で換算)
  - 後距離のうちに2400までは上がりきらない(終わりの速度は約2180 / 1860 / 1970)。次が直線ならそこで加速度25000で追いつく。ターンごとの通過速度(モード1 No.10・No.11)では、次のターンの速度をそこに合わせて下げる。コーナー2400(モード1 No.8・No.9)で次がすぐターンのときは、入口で目標速度が2400へ跳ぶ
- **最初のターンのあいだだけ吸引を70に上げるようにした**(`Move.c`の`SHORT_FIRST_SUCTION`、`motor.c`の`Suction_Boost_Start()`/`Suction_Boost_End()`)。最初のターンはモード4 No.9〜11(吸引70)で合わせたので、吸引50の2000では走らなかった。発進前に上げて500ms待ち、後距離の終わりで元の吸引に戻す。ターンのPIDゲインの組(`Sula_Flag`)も吸引70のものにする。吸引が70以上の走行(2400、2700、ターンごと)では何もしない
- 最初のターンを実機で調整した(前距離, 角度, 最大角速度, 角加速度, 後距離)
  - 大回り90(1480): 45, 90, 1184, 31640, 80(1500で 45, 90, 1200, 32500, 80 に合わせたものを換算)
  - 斜め入り45(1110): 15, 45, 1000, 23000, 70
  - 斜め入り135(1400): 38, 135, 1100, 30000, 60

## 2026-10-07
- **ターンごとの通過速度(`Short_NANAME_MoveTurnV`)を2400基準に作り直し、モード1 No.10(BFS)・No.11(ダイクストラ)に入れた**。旋回のパラメータは`Short_NANAME_Move2400`の値を速度に合わせて換算する。初期値はV90 2200、斜め入り45・斜め入り135・斜め出135 2400、大回り90 2600、大回り180 2500、斜め出45 2600。走り出しも2400と同じにした
  - ターンが直線を挟まずにつながるときは、前のターンの後距離のうちに次のターンの速度へ変える(加速度30000、後距離の8割)。以前は遅い方にそろえていた(`SpeedPlan.c`の`turn_back`/`ac_back`)
  - `motor.c`の`Motor_Wallcut_END_Accel`系が減速もできるようにした(`Accel_Target_Update`)
  - ターン単体を表の速度で走るモード10 No.1〜7を追加
- **他の人のターン速度の決め方・前後距離・速度のつなぎ方の調査メモを`docs/turn_speed_research.md`に置いた**

- **最初のターンの速度をターンごとにした**(大回り90 1500、斜め入り45 1570、斜め入り135 1900)。最初のターンのすぐ後がまたターンの経路(最初がターンの経路の約8割)でも、後距離のうちに2400まで上がりきるようにした。`G_First_Turn`に速度の列を足した
- **最初のターンで180°回って壁に当たる不具合を修正**。先頭の -1(圧縮で0になった直線)をターンとして読み、大回り180として曲がっていた。先頭の -1 を飛ばすようにし、`test/test_shortpath.c`に最初の命令の形の確認を足した
- **`WallDist_Scale`を実機で測った値(1.01, 0.99, 1.02, 1.06)にした**。`test/test_walldist.c`は倍率を1にして表そのものを確かめるようにした
- **最短走行の最初のターンを調整するモードを追加**(モード4 No.9〜No.11、右大回り90・右斜め入り45・右斜め入り135)。パラメータは`Move.c`の`G_First_Turn`(前距離・角度・最大角速度・角加速度・後距離・速度)にまとめた
- **最短走行で最初が直線のとき、スタート区画の境目まで(114mm)なめらかに加速するようにした**(`Move.c`の`Short_Start()`)。加速度は π V² / (4 × 114)(2400で約39700)。最初がターンのときは、最初のターンだけ専用の速度(`G_First_Turn`、1000のターンの軌跡を速度に合わせたもの)で曲がり、後距離で最高速へ加速する(`Short_First_Turn()`、加速度`SHORT_FIRST_AC`、詳細はTODO.md)。次の直線は後距離の終わりの速度から、最高速に届くまで同じ加速度で加速する(`Short_Catchup()`)
- **横壁制御を距離版(`G_WallCtrl_Use_mm = 1`)に切り替えた**。対策後の直進テストのログで、角速度の振れが最大 +67/−85°/s(センサ値版は +175/−118°/s)だった。探索・最短走行もすべて距離版になる。モード4 No.8 はセンサ値版で走る(比較・切り戻し用)
- **距離版の横壁制御(`G_WallCtrl_Use_mm = 1`、モード4 No.8)の揺れ対策**。ログで比べると、遠い壁や壁の切れ目でセンサ値版の約2倍のキックが出ていた(遠い壁ほどmmの誤差が大きくなるため)。距離版だけ次のようにした(センサ値版は変えていない)
  - 壁まで`WallCtrl_mm_MaxDist`(104mm、区画中心から±20mm)より遠い壁は使わない
  - 片側の誤差を`WallCtrl_mm_ErrMax`(±20mm)で頭打ち
  - 壁の切れ目の判定を1msの変化25(`Sensor_diff_TH_mm`、センサ値版は50)に
  - 壁の有無が切り替わった瞬間はD項を出さない
- **横壁制御のD項が左のモーターにしか効いていなかった不具合を修正**。`calWallConrol()`は1msに3回(左PWM・右PWM・ジャイロ目標)呼ばれ、2回目以降は前回の誤差が更新済みでD項が0になっていた。計算を`Wall_Control_Update()`で1msに1回だけ行い、3か所で同じ値を使うようにした
- **直進中のジャイロ側の横壁制御の向きが、直前のターンで逆になっていた不具合を修正**。ジャイロPIDの目標の符号を`Turn_Mode`(最後のターンの向き)で決めていたため、左ターンのあとは壁に寄る向きに効き、左右のPWMへの横壁制御と打ち消し合っていた。直進中(`G_Motor_Flag == 1`)は常に壁から離れる向きにした
  - どちらも直進の壁制御の効きが変わる(左ターンのあとは強くなる)。モード4 No.1でふらつきを見て、必要なら`Kp`/`Kd`を下げる
- **モード4 No.8を追加**。No.1と同じ直進を、横壁制御を距離[mm]で(`G_WallCtrl_Use_mm = 1`、ゲインは`Kp_mm`/`Kd_mm`)走る。No.1と比べるため
- **ログに横壁制御の誤差と出力を追加**(列の最後に2列)。RAMは16×16迷路で約101KB/128KB。32×32迷路のビルドは、追加前から約4KB足りない

## 2026-10-06(実機確認で見つかったもの)

- **探索のスラロームで、前壁があるとき境目からすぐターンしていた不具合を修正**。ターン前の直進(`Motor_Sula_before`/`Motor_Sula_ST`)は前センサの平均が130を超えると打ち切っていたが、130は前壁まで約180mmで、境目(174mm)ではもう超えていた。前センサの値を距離に変換し、前壁までが`174 - 前距離`mmになったところでターンに入るようにした(前壁なしのときは今までどおり)。行き止まりのUターンや止まって計算するときも、区画中央で止まるようになる
- **既知区間加速で直線が半区画伸びる不具合を修正**。`Known_Pass_Generation()`に最短走行用の終端処理が入っていて、既知区間の最初に毎回90mm余分に直進し、最後の小回りが大回りになっていた(既知区間加速を使う探索)。元の動作に戻した
- **壁制御の目標値を実測の区画中心の値に変更**。横壁制御`Wall_L`/`Wall_R`を220/200→243/206、前壁合わせ`FlontWall_Distance`を530→636。以前は片側の壁だけのとき中心から数mmずれた位置に、前壁合わせでは区画中心より約8mm手前に合わせていた
- **ダイクストラ誘導の未知壁探索で、ダイクストラを機体が止まっているときだけ計算するようにした**。以前はゴールに着いた直後とUターンのあとに、1000mm/sで走りながら計算していた(約9ms、約1cm伸びる)
- **Uターンの位置合わせで、壁のない方向に前壁合わせをして急に前進する不具合を修正**。`Robot_adjustment()`(左90°×2)の2回目の前壁合わせを、元の左の壁で判定するようにし、合わせる前に今の前センサの値(`Wall_Flont_Av() > 200`)でも壁を確かめるようにした。吸引探索のゴール後の最初のUターンからログ(`LOG.c`)を取る仕組みも入れた(モード4 No.7で出力)
- **モード1の番号を並べ替え**、`main.c`の`Maze_Shortest_Run()`にまとめた。No.1〜3がBFS、No.4〜9がダイクストラ。ダイクストラのコーナー2400(`Short_Dijkstra_Move2400`)を追加。コーナー2700とターンごとの通過速度はモード1から外した
- **モード0の番号を並べ替え**、探索の流れを`main.c`の`Maze_Search()`にまとめた。探索のあとに最短まで走るものはNo.8〜10にまとめた(最短はどれもモード1 No.5と同じ)。スラローム片道(No.3)、既知区間加速なしのダイクストラ誘導(No.6)、スラローム往復→最短(No.8)を追加
- モード3 No.0の出力に、主な迷路計算の最大時間(`TIME_MAX_US`、実機のみ)を追加。実測(Debugビルド -O0)はダイクストラ約9ms、壁の記録+歩数マップ約2ms、歩数マップ約1.5ms

## 2026-10-05(PCでの検証で見つかったもの)

- **ダイクストラの経路が壁に突っ込む不具合を修正**。境界ノードが通過の向きを持っていなかったため、あとから向きが入れ替わったノードの先に古いつながりが残り、「マスに入って横へ抜け、同じマスに戻る」走れない経路ができていた(ランダム迷路5000個中4個)。ノードを向きごとの状態に分けて書き直した
- **BFS最短がゴールの1マスだけを目指していたのを修正**。2×2区画のほかのマスから入る方が近い迷路で1〜2マス遠回りになっていた(ループのあるランダム迷路で約4%)
- **最短経路の計算が固まる不具合を修正**。未確認の壁を壁とみなすとスタートからゴールへ行けない場合(探索が途中で止まった等)、`Maze_Shortest_Calculation()`が永久ループしていた。空の経路を返すようにした。最短走行(`Move.c`の`Short_*`)は経路が空なら**走らずにエラー**(全LED点滅+低い音を3回、シリアルに`ERROR: no shortest path`)を出して戻る。モード3 No.0の出力にも`NO PATH`と出る
- モード3 No.0に迷路の出力(`Maze_Debug_Dump()`)、PCでの確認用に`test/test_shortpath.c`を追加

## それ以前

- **行き止まり潰し(`Maze_DeadEnd_Fill()`)を追加**。確認済みの壁だけで出入口が1つ以下のマスを連鎖的に閉じ、エセ全面探索の目標候補から外す。壁マップは書き換えず、通行判定にも使わないため、誤判定の最悪ケースが「そのマスを探索しない」で頭打ちになるようにしてある(詳細は`maze_algorithm.md`)
- ホスト上で`Core/Src/Maze.c`を直接リンクして回すテスト(`test/test_deadend.c`)とCI(`.github/workflows/maze-test.yml`)を追加
- `Maze_Dijkstra_Calculation()`: FIFOキュー+早すぎる確定ロックによりダイクストラとして不正だった箇所をSPFA(再緩和可能なキュー)に修正
- 経路配列(`G_Short_Pass`/`_CP`/`_NANAME`)の終端が正しく0に戻されず、短い経路の後に前回の長い経路の残骸を読み進めてしまうバグを修正
- ダイクストラのゴール判定が「ゴールセルを通り抜けた奥の境界」を起点にしていたため、普通の最短(BFS)より1マス多く進んでしまうバグを修正。ゴール2×2区画を囲む8境界すべてを起点にするマルチソース方式に変更(侵入方向を問わず、区画に入った時点で停止)
- `LOG.c`の境界チェックの off-by-one(配列を1要素分オーバーランするバグ)を修正、あわせてログ長を3000→2000サンプルに削減してRAMを確保
