Tokoro0917/KOGUMA.MkIIl/TODO.md

# やることリスト

2026-10-12時点。九州地区大会は **2026-10-25**。上から順に進める。終わったことと決めたことは、いちばん下の「記録」。

大会までの優先順は2つ。これが固まるまで、ほかの調整(ターン・速度)には手を付けない。壁制御がふらつくと、壁切れの位置もターンの入り方もずれるので、この順で進める。

1. **壁制御の安定化**
2. **壁切れを完璧にする**(柱を壁切れとして使う。設計は`docs/pillar_cut_design.md`)

## 予定

| 日付 | やること | 状態 |
|---|---|---|
| 10-12 | ソフトの準備(柱の壁切れ、ログ、出力、ビューア) | 済み(実機は未確認) |
| 10-13 | 実機の準備: ハードの確認、CubeIDEでビルド、ビューアの接続(下の「0. 次に実機でやること」) | |
| 10-13〜10-16 | **第1: 壁制御の安定化** | |
| 10-16〜10-20 | **第2: 壁切れを完璧にする**。10-20に、大会で柱の壁切れを使うか決める | |
| 10-20〜10-21 | **第3: 大会で走らせるものを仕上げる**(探索と2000の最短)。本番で走らせる番号を決める | |
| 10-22 | 通しのリハーサル(感度合わせ → 探索 → 最短 → 出力)を2〜3回 | |
| 10-23 | コードを凍結してタグを付ける。以降は感度合わせの値だけ変える | |
| 10-24 | 持ち物の確認 | |
| 10-25 | 大会 | |

## 0. 次に実機でやること(10-13)

ログはビューアで取る: `tools/viewer.html`をChromeで開いて「接続」、「保存先フォルダ」で`logs/`を選ぶ。走らせたら、電源を切らずに出力(モード4 No.7)。保存したファイルをプッシュすれば、Claudeが元のデータを読む。

- [ ] **STM32CubeIDEでビルドして書き込む**(2026-10-07 以降の変更はCubeIDEでは未確認。ARMのgccでは通る)
- [ ] **ビューアがつながるか**: モード4 No.0(センサ表示)で「センサの値(そのまま)」のグラフが動くか。出力(モード4 No.7)で迷路が届くか。だめなら`tools`で`python -m http.server`して`http://localhost:8000/viewer.html`
- [ ] **ハードの確認**: ギアの滑り、タイヤ、電池、前センサの向き(10-08の衝突のあと)
- [ ] **10-08の斜めの不調の切り分け**: 変更前の master(41367be)を書き込んで同じ経路を走らせ、コードかハードかを分ける(すべての斜めのパターンで調子が悪くなった。斜めのコードは変えていない)

## 第1: 壁制御の安定化(10-13〜10-16)

ゴール: 区画の中心を、探索(500・1000mm/s)でも最短の直線でも、揺れずに走る。ログは走行ログ(モード4 No.1・No.8 → 出力)。ビューアの「横の壁までの距離」「横壁制御(出力・P項・D項)」「使った壁」「横センサの値」で見る。ほかの人のやり方は`docs/wall_research.md`。

- [ ] **左センサのノイズの原因を探す**(ハード)。2026-10-10のログで、左センサだけ4msおきに1回落ち込んでいた。走行ログの「横センサの値(LPFだけ)」で見える。配線・コネクタ・発光LED・受光の向き・発光と読み取りのタイミングを見る。直ったら`WallCtrl_mm_StableTH`を15→8に戻す
- [ ] **距離版とセンサ値版のどちらで行くか決める**(10-14まで)。同じ置き方・同じ速度でモード4 No.1(距離版)とNo.8(センサ値版)のログを取り、ビューアで破線で重ねて、角速度と誤差の振れを比べる。センサ値版のほうがふらつきが少ないなら、本番はセンサ値版(`G_WallCtrl_Use_mm = 0`)。今の距離版のゲインはセンサ値版と同じ効き(`Kp_mm` 0.30 / `Kd_mm` 0.06、2026-10-10)
- [ ] **中心からずらして置いたときの戻り**(左右に10mmずつ)。戻りが遅い・行き過ぎるなら`Kp`/`Kd`を直す
- [ ] **速度ごとの効き**: 500(スラローム探索)・1000(吸引探索)・2000以上(最短の直線)。ゲインは速度/500倍(2000以上は4倍)なので、速いほうで揺れていないか
- [ ] **壁が出てきた瞬間の段差(約+20)と、片壁区間の1msごとの振れ**(D項がセンサのばらつきを拾う)を小さくする。試すこと(`docs/wall_research.md`): 使う/使わないの切り替えに幅を持たせる、近いほうの壁だけ使う、中心付近の不感帯、D項を数msの差で取る
- [ ] **減速して止まるときの片寄り**(`WallCtrl_mm_GainMin`は今0)
- [ ] `WallDist_Scale`(0.99, 0.96, 1.00, 1.02)を区画中心で測り直す(モード3 No.5)。左右の距離が中心で同じになっているか
- [ ] 完了の目安: 探索(モード0 No.4)を全面迷路で続けて5回、壁に当たらず、ログで中心からのずれが小さいこと

## 第2: 壁切れを完璧にする(10-16〜10-20)

ゴール: 壁切れが、左右・壁あり/なし・速度によらず、毎回同じ位置で反応する。

- [ ] **モード3 No.6〜9を実機で走らせる**(壁の終わり(#2)と柱だけ(#3)がある直線で、500・1000・2000・2400、同じ置き方)。ビューアの「横センサの値と距離」で柱のところの下がり方を見て、柱だけの山の高さ H から`Edge_Min_High`を決める。「まとめ」の c-border が0になるように`Edge_Off`(左右・種類ごと、ビューアが書き写す行を出す)を直し、速度でばらつかないかを見る
- [ ] **機体を横に±5mmずらして置いて**モード3 No.7。見える位置の変わり方から`Edge_Tan`を決める
- [ ] **従来のまま最短走行し、出力でログを取る**。ビューアの「前距離(従来)」の「直した量」と、「後距離」で X より早く壁切れして終わっていないかを見る(早く終わっていたら、柱に替えると後距離が長くなる)
- [ ] **`Short_WallCut_Pillar` = 1 で最短走行**(2000から)。「前距離(柱)」でどの推定を使ったか、直した量のばらつきが従来より小さいか、ターンの入りが同じか良くなるか
- [ ] **柱が見つからなかったとき**(使った推定が「見つからず」)の動き。距離だけで走ってもターンが大きくずれないか
- [ ] **斜めの壁切れ**(`Cut_L_NA`/`Cut_R_NA` = 150、いまは従来どおり)。10-08の斜めの不調と関係がないか、モード6の斜めのターン(No.3〜7)で反応位置を見る
- [ ] **会場で合うか**: 別の壁でモード3 No.6〜9を走らせ、c-border が変わらないか(柱の方法は明るさに左右されにくいつくり)
- [ ] 10-20に、大会で柱の壁切れを使うか決める。使わないなら、従来の壁切れで`G_WallCut_Fast`を使うか決める(閾値の av と med の差が速度で開く〈2400で約5mm〉なら1にして合わせ直す)
- [ ] 完了の目安: 2000の最短(モード1 No.2・No.5)を続けて5回完走し、ログの壁切れの位置のばらつきが小さいこと

## 第3: 大会で走らせるものを仕上げる(10-20〜10-21)

- [ ] 探索(モード0 No.4・No.9・No.10)を全面迷路で確認
- [ ] **2000のターンを`G_Turn2000`(1つの表)で合わせ直す**(2026-10-09にタイヤ径を23.1mmにしたあと)。モード6 No.1〜7で合わせ、BFS(モード1 No.1〜3)とダイクストラ(モード1 No.4〜7、モード0の最短)で確認
- [ ] 2000で、最初がターンの経路(2026-10-09に最初のターン専用の動きを使わない形に戻した)と、最初が直線の経路が走るか
- [ ] 2026-10-08 終了時点の続き: ダイクストラ2000で右斜め入り45→斜め出45の経路のあと、右大回り90で外(左)に膨らみ、左斜め入り135のあとで壁に当たった(ログあり)。モード4 No.10 で斜めの通路の左に寄ることを確認。角加速度(今23000)を上げて合わせる(26000で約2.7mm、30000で約5.6mm、35000で約8.5mm右へ)。寄りがだんだん大きくなるなら角度(45)のほう
- [ ] 探索を途中で止めてモード1を選び、経路が空のときのエラー(全LED点滅+低い音3回、走らない)を確認
- [ ] `Short_Dijkstra_Move2000()`終端の旋回角度(180°→270°)の調整をリポジトリに反映するか確認
- [ ] 本番で走らせる番号を決める(下の「本番の手順」)

### 本番の手順(10-21に決める)

- 探索: モード0 No.__
- 最短1本目(確実なもの): モード1 No.__
- 最短2本目以降(攻める): モード1 No.__

## 大会前(10-22〜10-24)

- [ ] 会場での感度合わせの流れを決めておく(モード3 No.5で測る → ビューアの「感度合わせ」で書き写す行をコピー → ビルドし直す)。今の`WallDist_Scale`(0.99, 0.96, 1.00, 1.02)をどの迷路で測ったかもメモしておく
- [ ] 区画中心で測った倍率で、壁の判定・壁制御・前壁合わせが別の壁でも合うか、練習用の壁で一度試す
- [ ] 通しのリハーサル(感度合わせ → 探索 → 最短 → 出力)を2〜3回
- [ ] コードを凍結してタグを付ける(10-23)
- [ ] 持ち物: 予備の電池・充電器・書き込み用のPCとケーブル・USBシリアルのケーブル・タイヤの掃除道具。ビューアはネットなしで使えるので、PCに`tools/viewer.html`があればよい

## 大会のあと(この2週間ではやらない)

### 柱の壁切れの続き(`docs/pillar_cut_design.md`の段階2〜4)

- [ ] 上がる端(手前に壁がなく先に壁がある所)。左右の平均を増やす
- [ ] 地図から、どの境目でどの端が見えるはずかを前もって決める。直線の途中の境目でも位置を直す。探索にも使う
- [ ] 斜めの壁切れも柱に一本化する(いまは`Cut_L_NA`/`Cut_R_NA` = 150 の従来どおり)

### 最短走行の速さ

- [ ] **ターンごとの通過速度**(モード1 No.10・No.11、モード10。考え方は`docs/turnv_design.md`)
  - CubeIDEでビルドが通るか、`TurnV_Table`の`v`を全部2400にして`Short_NANAME_Move2400`(モード1 No.3)と同じ走りになるか
  - V90を2200にして(モード10 No.7)前距離・後距離を合わせる。2200でも怪しければ、原因が滑りか(横G)、柱・壁の補正かを見る。滑りでなければ、V90を基準にした速度の見積もり(`docs/turnv_design.md`)は当てはまらない
  - 大回り90・大回り180・斜め出45を初期値(2600/2500/2600)で合わせ、100〜200ずつ上げる(目安の上限 約2800/約2900/約2980。大回り180は慎重に)
  - 後距離で速度を変えるところ(連続ターン)が、壁切れで早く終わって速度が跳ばないか。斜め出45は後距離が40mmしかないので上げすぎない
- [ ] **加速しながら曲がる最初のターン**(モード4 No.12〜14、`G_First_Turn_Accel`)。ギアを直したら試す。軌跡がNo.9〜11と同じか、電圧が張り付かないか、横Gで滑らないか
- [ ] 2400の最初のターン(`G_First_Turn`、モード4 No.9〜11)
  - 前距離を変えたら、速度を「√(4×25000×(24+前距離)/π)」以下にする(`SHORT_FIRST_AC` = 25000)
  - 後距離のうちに2400までは上がりきらない(大回り90で約2180)。コーナー2400で最初のターンのすぐ後がターンの経路は、入口で目標速度が跳ぶ
  - 斜め入り45は前距離15mmだと約1110しか出せない。速く曲がりたいなら前距離を長くする
  - 最初が直線の経路(2400)
- [ ] 2700(`Short_NANAME_Move2700`)

### そのほか

- [ ] モード4 No.0(センサ表示)を、10回の移動平均ではなく生の値で出す(ノイズを見るため。main.c にコメントで書き方が残っている)
- [ ] 前の壁センサの表に、60mmより近い点(48、36mm)を足す
- [ ] 前壁制御の距離化: 前壁までの距離での停止位置補正、左右の前センサの距離差から傾き角度を求める
- [ ] 会場ごとの倍率をフラッシュに保存して、書き写さずに済むようにする
- [ ] 32×32迷路: RAMが足りない(16×16で約115KB/128KB)。使うならログを減らすなどしてRAMを空ける
- [ ] ダイクストラの計算(約9ms、Debugビルド -O0)を短くしたければ、CubeIDEのDebug設定の最適化を上げる(タイミングが変わるので走りを確認し直す)

## 記録(終わったこと・決めたこと)

### 2026-10-12

ソフトの準備(どれも実機では未確認。ARMのgccでのビルドとPCのテストまで)。中身は`docs/changelog.md`。

- 大会までの方針を決めた: 第1 壁制御の安定化、第2 壁切れを完璧にする。壁切れは**柱に一本化する**(斜めはあとで)
- ほかの人の壁制御・壁切れのやり方を調べた(`docs/wall_research.md`)
- 柱の壁切れを作った(段階1、`docs/pillar_cut_design.md`。`Short_WallCut_Pillar` = 0 が既定)。従来の前距離は、短い X(2400で3〜25mm)だと壁切れが効いていなかったはず
- 壁切れのテスト(モード3 No.6〜9)、最短走行の壁切れのログ(従来・柱とも前距離の始めと曲がり始め)
- 走行ログを選び直した(`docs/log_design.md`)。普段1msおき・最短4msおき。動作(phase)を残す
- 出力をモード4 No.7のひとつにまとめた
- ビューア(`tools/viewer.html`)を作った: USBシリアルを直接読み、グラフ・表・迷路にして`logs/`に保存する。センサの値の流れるグラフ、拡大を戻すボタン
- READMEを整理し、詳しい中身を`docs/`に移した

### 2026-10-07

- 横壁制御を距離版(`G_WallCtrl_Use_mm = 1`)にした。直進テストのログで、角速度の振れがセンサ値版の約半分。探索・最短走行で問題なし。モード4 No.8 は比較用にセンサ値版で走る
  - 最初の距離版は揺れた(遠い壁・切れ目のキックが約2倍)。104mmより遠い壁を使わない、片側の誤差を±20mmで頭打ち、切れ目の判定25、壁の有無が切り替わった瞬間はD項を出さない、で安定した
  - D項が左のモーターにしか効いていなかった不具合と、左ターンのあとジャイロ側が壁に寄る向きに効いていた不具合を直した(実機で確認済み)
  - ログ(モード4 No.7)の最後の2列に、横壁制御の誤差と出力を入れた
- 最短走行の走り出し
  - 最初が直線: スタート位置から区画の境目までの114mmで0→Vにcos加速する(加速度 = π V² / (4 × 114)、2400で約39700)。1.5区画以上の直線も、ここで加速してから残りを走る
  - 最初がターン: スタート位置から24mmで区画中心、そこから前距離・ターン・後距離。24mm+前距離では最高速まで加速できないので、最初のターンだけ専用の速度で曲がる。前距離までに0→速度、後距離で速度→最高速へ、どちらも加速度50000(`SHORT_FIRST_AC`)
  - 最初の版は、先頭の -1(圧縮で0になった直線)をターンとして読み、大回り180として曲がっていた(180°回って壁に当たった)。先頭の -1 を飛ばして読むように直し、`test/test_shortpath.c`に最初の命令の形の確認を足した。ランダム迷路では最初のターンは大回り90・斜め入り45・135だけで、どれも先頭に -1 がある(大回り180はスタートからは出ない)
  - 最初のターンのすぐ後がまたターンの経路は、最初がターンの経路の約8割(555本中433本)。次の区間に頼らないように、ターンごとの速度を後距離のうちに2400まで上がりきる値にした
  - 最初のターンの直後の直線は、最高速に届くまでの区間だけ加速度50000で加速する(`Short_Catchup()`)
  - 2000・2400で最初が右斜め入り135の経路が走ることを確認
  - `G_Wall_data`は1msごとの割り込みで更新されているので、走り出す前に1にしなくてよい
- 会場ごとの倍率`WallDist_Scale`を実機の値(1.01, 0.99, 1.02, 1.06)にした。`test/test_walldist.c`は倍率を1にして表そのものを確かめるようにした
- モード1の全番号を実機で確認済み
- ターンごとの通過速度を2400基準に作り直し、モード1 No.10・No.11、モード10に入れた(別セッション、未確認)

### 2026-10-06

- 壁センサの表を実測値にした(横 37〜133mm の9点、前 60〜204mm の13点)。壁制御の目標値も区画中心の実測値にした(`Wall_L`/`Wall_R` 243/206、`FlontWall_Distance` 636)
- Uターンの前壁合わせのしきい値`ALIGN_FRONT_MIN` = 200 は妥当(前壁まで約144mm。区画中心で前壁ありは約636、前壁なしは112未満)
- 探索のスラロームで、前壁があるときに境目からすぐターンしていた不具合を直した(実機で確認済み)。次の2つは、実機の走りに問題がないので直さないことにした
  - スラローム探索(500)の後距離25(計算上は20)
  - 吸引探索(1000)の前15/後50(計算上は32.5/32.5。滑りを見越した値として残す)。既知区間加速(1000)は前20/後48
- モード0の全番号を実機で確認済み(No.4はUターンの位置合わせの修正後にOK)
