Tokoro0917/KOGUMA.MkIIl/KOGUMA.MkII/KOGUMA.MkII.ioc

Mcu.UserName=STM32F446RETx
PA0-WKUP.GPIO_Label=WallLED_34
PA0-WKUP.Signal=GPIO_Output
PA1.GPIO_Label=WallLED_12
PA1.Signal=GPIO_Output
PA10.Signal=GPIO_Output
PA11.Signal=GPIO_Output
PA12.Signal=GPIO_Output
PA13.Signal=SYS_JTMS-SWDIO
PA14.Signal=SYS_JTCK-SWCLK
PA15.GPIO_Label=ENCO_R_NSS
PA15.Signal=GPIO_Output
PA2.Signal=USART2_TX
PA3.GPIO_Label=LEDF1
PA3.Signal=GPIO_Output
PA4.GPIO_Label=ICM_NSS
PA4.Signal=GPIO_Output
PA5.Signal=SPI1_SCK
PA6.Signal=SPI1_MISO
PA7.Signal=SPI1_MOSI
PB0.Signal=SPI3_MOSI
PB1.Signal=ADCx_IN9
PB12.GPIO_Label=LED1
PB12.Signal=GPIO_Output
PB13.GPIO_Label=LED2
PB13.Signal=GPIO_Output
PB14.GPIO_Label=LED3
PB14.Signal=GPIO_Output
PB4.GPIO_Label=LED4
PB4.Signal=GPIO_Output
PB5.GPIO_Label=LED5
PB5.Signal=GPIO_Output
PB6.GPIO_Label=LED6
PB6.Signal=GPIO_Output
PB8.Signal=S_TIM2_CH1_ETR
PB9.Signal=S_TIM4_CH4
PC0.Signal=ADCx_IN10
PC1.Signal=ADCx_IN11
PC10.Signal=SPI3_SCK
PC11.Signal=SPI3_MISO
PC13.GPIO_Label=LEDF4
PC13.Signal=GPIO_Output
PC14-OSC32_IN.GPIO_Label=LEDF3
PC14-OSC32_IN.Signal=GPIO_Output
PC15-OSC32_OUT.GPIO_Label=LEDF2
PC15-OSC32_OUT.Signal=GPIO_Output
PC2.Signal=ADCx_IN12
PC3.Signal=ADCx_IN13
PC5.GPIO_Label=ENCO_L_NSS
PC5.Signal=GPIO_Output
PC6.Signal=S_TIM3_CH1
PC7.Signal=S_TIM3_CH2
PC8.Signal=S_TIM3_CH3
PC9.Signal=S_TIM3_CH4
PH0-OSC_IN.Signal=RCC_OSC_IN
PH1-OSC_OUT.Signal=RCC_OSC_OUT
