Tokoro0917/KOGUMA.MkIIl/KOGUMA.MkII/Core/Inc/main.h

#define LEDF4_Pin GPIO_PIN_13
#define LEDF4_GPIO_Port GPIOC
#define LEDF3_Pin GPIO_PIN_14
#define LEDF3_GPIO_Port GPIOC
#define LEDF2_Pin GPIO_PIN_15
#define LEDF2_GPIO_Port GPIOC
#define WallLED_34_Pin GPIO_PIN_0
#define WallLED_34_GPIO_Port GPIOA
#define WallLED_12_Pin GPIO_PIN_1
#define WallLED_12_GPIO_Port GPIOA
#define LEDF1_Pin GPIO_PIN_3
#define LEDF1_GPIO_Port GPIOA
#define ICM_NSS_Pin GPIO_PIN_4
#define ICM_NSS_GPIO_Port GPIOA
#define ENCO_L_NSS_Pin GPIO_PIN_5
#define ENCO_L_NSS_GPIO_Port GPIOC
#define LED1_Pin GPIO_PIN_12
#define LED1_GPIO_Port GPIOB
#define LED2_Pin GPIO_PIN_13
#define LED2_GPIO_Port GPIOB
#define LED3_Pin GPIO_PIN_14
#define LED3_GPIO_Port GPIOB
#define ENCO_R_NSS_Pin GPIO_PIN_15
#define ENCO_R_NSS_GPIO_Port GPIOA
#define LED4_Pin GPIO_PIN_4
#define LED4_GPIO_Port GPIOB
#define LED5_Pin GPIO_PIN_5
#define LED5_GPIO_Port GPIOB
#define LED6_Pin GPIO_PIN_6
#define LED6_GPIO_Port GPIOB
