Tokoro0917/KOGUMA.MkIIl/KOGUMA.MkII/Core/Inc/Define.h

/*
 * Define.h
 *
 *  Created on: Jun 14, 2025
 *      Author: akihi
 */

#ifndef INC_DEFINE_H_
#define INC_DEFINE_H_

#define MAZE_GOOL_X 7
#define MAZE_GOOL_Y 7


#define MAZE_SIZE 16
#define MAX_STEP 256


#define TIREDIAMETER 23.48 //mm
#define TIREBETWEEN 55
#define PI 3.1415
#define LIMITBATT 15.6
#define REFERENCE_V 16.0

#define INTERRUPTTIME 0.001//5kHz 0.0002 1kHz 0.001

#define ROBOT_M 0.078

#define MOTORR 5.4
#define KT 0.003
#define KE 0.000414

#define GEARRATIO 1.7073

#define MAX_MAZE_STEP 255
#define MAX_QUEUE_NUM 100

#define DIJK_MAXCOST 999
#define DIJK_WALLCOST 1000
#define MAX_QUEUE_NUM 1000

#define ST_COST 5
#define DIAG_COST 3
#define CON_COST 2

#endif /* INC_DEFINE_H_ */
