Tokoro0917/KOGUMA.MkIIl/KOGUMA.MkII/Core/Inc/Maze.h

/*
 * Maze.h
 *
 *  Created on: 2023/08/18
 *      Author: akihi
 */

#define INC_MAZE_H_
#define INC_MAZE_H_

#include"Define.h"

typedef struct {
	int head;
	int tail;
	int data[MAX_QUEUE_NUM];
} QUEUE_T;

typedef struct {
	int head;
	int tail;
	int data[MAX_QUEUE_NUM];
} STACK_T;

extern int G_Gool_X;
extern int G_Gool_Y;

extern int G_MAZE_Explored[MAZE_SIZE][MAZE_SIZE];

extern int G_Maze_Row[MAZE_SIZE+1];
extern int G_Maze_Column[MAZE_SIZE+1];

extern int G_Robot_Direction;
extern int G_Robot_Lastaction;

extern int G_Maze_Flont;
extern int G_Maze_Back;
extern int G_Maze_Left;
extern int G_Maze_Right;

extern int G_Robot_MAZE_X;
extern int G_Robot_MAZE_Y;

extern int G_Maze_Row_Save[MAZE_SIZE+1];
extern int G_Maze_Column_Save[MAZE_SIZE+1];

extern int G_Step_Map[MAZE_SIZE][MAZE_SIZE];

extern int G_Short_Pass[MAX_STEP];
extern int G_Short_Pass_CP[MAX_STEP];
extern int G_Short_Pass_NANAME[MAX_STEP];

extern int G_Known_Pass[MAX_STEP];

void pushQueue_walk(QUEUE_T*, unsigned short);
unsigned short popQueue_walk(QUEUE_T*);

void pushStack_walk(STACK_T*, unsigned short);
unsigned short popStack_walk(STACK_T*);

void Maze_Initialization();
void Maze_Wall_Search(int, int, int);
void Maze_Wall_Update();

void Maze_Unkown_ALL_ModeSet();
void Maze_Unkown_ALL_ModeOFF();
int Maze_All_MODE_Check();

void Maze_Gool_Setting(int );
void Maze_Step_Calculate();

void Known_Pass_Generation();

void Maze_Mapping();
void Maze_Save();
void Maze_Road();
void Maze_Look_Mapping();
void Maze_Wall_fill();
void Maze_Shortest_Calculation();
void Shortest_Pass_Compression();
void Shortest_Pass_Compression_NANAME();
void Pass_zero_act();


void  Maze_Dijkstra_Calculation();
void Maze_Dijkstra_Mapping();
