Tokoro0917/KOGUMA.MkIIl/KOGUMA.MkII/Core/Src/UI.c

/*
 * UI.c
 *
 *  Created on: May 30, 2024
 *      Author: akihi
 */

#include <UI.h>
#include "gpio.h"
#include "tim.h"
#include "PL_encoder.h"

void LED_Reset() {
	HAL_GPIO_WritePin(LED1_GPIO_Port, LED1_Pin, 0);
	HAL_GPIO_WritePin(LED2_GPIO_Port, LED2_Pin, 0);
	HAL_GPIO_WritePin(LED3_GPIO_Port, LED3_Pin, 0);
	HAL_GPIO_WritePin(LED4_GPIO_Port, LED4_Pin, 0);
	HAL_GPIO_WritePin(LED5_GPIO_Port, LED5_Pin, 0);
	HAL_GPIO_WritePin(LED6_GPIO_Port, LED6_Pin, 0);
}

void LED_ALL_ON() {
	HAL_GPIO_WritePin(LED1_GPIO_Port, LED1_Pin, 1);
	HAL_GPIO_WritePin(LED2_GPIO_Port, LED2_Pin, 1);
	HAL_GPIO_WritePin(LED3_GPIO_Port, LED3_Pin, 1);
	HAL_GPIO_WritePin(LED4_GPIO_Port, LED4_Pin, 1);
	HAL_GPIO_WritePin(LED5_GPIO_Port, LED5_Pin, 1);
	HAL_GPIO_WritePin(LED6_GPIO_Port, LED6_Pin, 1);
}

void LED_Setup_Robot() {
	HAL_GPIO_WritePin(LED1_GPIO_Port, LED1_Pin, 0);
	HAL_GPIO_WritePin(LED2_GPIO_Port, LED2_Pin, 0);
	HAL_GPIO_WritePin(LED3_GPIO_Port, LED3_Pin, 0);
	HAL_GPIO_WritePin(LED4_GPIO_Port, LED4_Pin, 0);
	HAL_GPIO_WritePin(LED5_GPIO_Port, LED5_Pin, 0);
	HAL_GPIO_WritePin(LED6_GPIO_Port, LED6_Pin, 0);
	HAL_Delay(100);
	HAL_GPIO_WritePin(LED1_GPIO_Port, LED1_Pin, 1);
	HAL_Delay(100);
	HAL_GPIO_WritePin(LED2_GPIO_Port, LED2_Pin, 1);
	HAL_Delay(100);
	HAL_GPIO_WritePin(LED3_GPIO_Port, LED3_Pin, 1);
	HAL_Delay(100);
	HAL_GPIO_WritePin(LED4_GPIO_Port, LED4_Pin, 1);
	HAL_Delay(100);
	HAL_GPIO_WritePin(LED5_GPIO_Port, LED5_Pin, 1);
	HAL_Delay(100);
	HAL_GPIO_WritePin(LED6_GPIO_Port, LED6_Pin, 1);
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
		HAL_GPIO_WritePin(LED3_GPIO_Port, LED3_Pin, 1);
	}
}

void LED_ON_R() {
	HAL_GPIO_WritePin(LED5_GPIO_Port, LED5_Pin, 1);
	HAL_GPIO_WritePin(LED6_GPIO_Port, LED6_Pin, 1);
}

void LED_ON_L() {
	HAL_GPIO_WritePin(LED1_GPIO_Port, LED1_Pin, 1);
	HAL_GPIO_WritePin(LED2_GPIO_Port, LED2_Pin, 1);
}

void LED_StartWait() {
	HAL_GPIO_WritePin(LED1_GPIO_Port, LED1_Pin, 0);
	HAL_GPIO_WritePin(LED2_GPIO_Port, LED2_Pin, 1);
	HAL_GPIO_WritePin(LED3_GPIO_Port, LED3_Pin, 0);
	HAL_GPIO_WritePin(LED4_GPIO_Port, LED4_Pin, 1);
	HAL_GPIO_WritePin(LED5_GPIO_Port, LED5_Pin, 0);
	HAL_GPIO_WritePin(LED6_GPIO_Port, LED6_Pin, 1);
	HAL_Delay(200);
	HAL_GPIO_WritePin(LED1_GPIO_Port, LED1_Pin, 1);
	HAL_GPIO_WritePin(LED2_GPIO_Port, LED2_Pin, 0);
	HAL_GPIO_WritePin(LED3_GPIO_Port, LED3_Pin, 1);
	HAL_GPIO_WritePin(LED4_GPIO_Port, LED4_Pin, 0);
	HAL_GPIO_WritePin(LED5_GPIO_Port, LED5_Pin, 1);
	HAL_GPIO_WritePin(LED6_GPIO_Port, LED6_Pin, 0);
	HAL_Delay(200);
}

void Buzzer_Number_Change() {
//	HAL_TIM_PWM_Start(&htim4, TIM_CHANNEL_4);
//	__HAL_TIM_SET_COMPARE(&htim4, TIM_CHANNEL_4, 10);
//	__HAL_TIM_SET_AUTORELOAD(&htim4, 5000);
//
//	HAL_TIM_PWM_Stop(&htim4, TIM_CHANNEL_4);
}

void Buzzer_Mode_Change() {

}

void Buzzer_Enter() {
	HAL_TIM_PWM_Start(&htim4, TIM_CHANNEL_4);
	__HAL_TIM_SET_COMPARE(&htim4, TIM_CHANNEL_4, 20);
	__HAL_TIM_SET_AUTORELOAD(&htim4, 3000);
	HAL_Delay(300);
	HAL_TIM_PWM_Stop(&htim4, TIM_CHANNEL_4);
}

void Buzzer_Start() {
	HAL_TIM_PWM_Start(&htim4, TIM_CHANNEL_4);
	__HAL_TIM_SET_COMPARE(&htim4, TIM_CHANNEL_4, 20);
	__HAL_TIM_SET_AUTORELOAD(&htim4, 3000);
	HAL_Delay(400);
	__HAL_TIM_SET_AUTORELOAD(&htim4, 1500);
	HAL_Delay(400);
	HAL_TIM_PWM_Stop(&htim4, TIM_CHANNEL_4);
}
