Tokoro0917/KOGUMA.MkIIl/(commit log)

2026-07-21 Initial commit: KOGUMA MkIIl micromouse firmware
    STM32F446RE-based micromouse robot firmware, including maze search/
    shortest-path algorithms (BFS + SPFA-based Dijkstra with diagonal
    move costs), motor control, wall sensors, and telemetry logging.
    [Define.h, Failsafe.c, KOGUMA.MkII.ioc, LOG.c, Maze.c, Maze.h, Move.c, Move.h]
2026-07-21 Fix Dijkstra shortest-path goal detection to match BFS behavior
    - Shortest_Pass_Compression()/Shortest_Pass_Compression_NANAME() left
    their array terminator overwritten by a lookahead placeholder without
    restoring it to 0, so a later shorter run could read stale tail data
    left over from a previous longer run (garbage motion after reaching
    a close goal).
    - Maze_Dijkstra_Calculation() seeded cost=0 only at the goal cell's far
    boundary, so the robot drove one extra cell through the goal before
    stopping, unlike Maze_Shortest_Calculation() which stops on entry.
    Now seeds all 8 boundary nodes around the 2x2 goal region as a
    multi-source start, matching entry-detection from any side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
    [Define.h, Maze.c, main.c]
2026-07-22 Fix U-turn handling in known-section acceleration dead ends
    Known_Pass_Generation() was missing the 180-degree direction update
    in its dead-end branch that its sibling reactive functions
    (Robot_Maze_Sula_Action/Robot_Maze_Suction_Action) already have. This
    let the simulated heading desync from the real maze topology once the
    walk hit a three-walled cell, causing it to "pass through" walls and
    potentially write past the fixed-size G_Known_Pass/Known_Pass_CP
    buffers.
    This was latent in normal single-goal runs (a shortest-path walk
    rarely needs to detour into a dead end), but full-exploration mode
    deliberately routes the robot into every unexplored pocket, so
    running known-section acceleration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
    [Maze.c, Move.c]
2026-07-23 Prepare diagonal (NANAME) compression for known-section acceleration
    Ports the proven diagonal-move compression pattern from the shortest-path
    pipeline (Shortest_Pass_Compression_NANAME) to known-section acceleration,
    matching its three-array design: G_Known_Pass -> Known_Pass_CP -> new
    Known_Pass_NANAME.
    - Add Known_Pass_NANAME[] array, mirroring G_Short_Pass_NANAME.
    - Port the term_idx + sentinel technique (already used in
    Shortest_Pass_Compression) into Known_Pass_Generation()'s wide-turn
    compression loop, fixing a latent bug where a shorter burst could
    replay stale data left over from a previous, longer burst.
    - Add Known_Pass_Compression_NANAME(), replacing the old in-place,
    co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
    [Maze.c, Maze.h, Move.c]
2026-07-23 Add Dijkstra-guided unknown-wall shuttle search (Adachi-method style)
    Adds a new exploration strategy alongside the existing full-maze
    exploration mode: after an initial start-to-goal run, shuttle back and
    forth between goal and start, computing a Dijkstra shortest path from
    current knowledge before each leg and detouring only to resolve the
    first unconfirmed wall along that path, rather than exhaustively
    visiting every unexplored cell. Repeats until a path is found with
    every wall along it confirmed, then runs the existing high-speed
    Dijkstra run.
    - Maze_Dijkstra_Calculation() takes a direction argument (start->goal
    or goal->start), swapping which side seeds the flood-fill and which
    si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
    [Maze.c, Maze.h, Move.c, main.c]
2026-07-24 Simplify Dijkstra-guided unknown-wall search; add PC simulator/visualizer
    Drop the goal<->start shuttle structure from the unknown-wall exploration
    mode: Maze_Dijkstra_Calculation() reverts to its original fixed
    start->goal signature (the goal->start direction and its backtrace-anchor
    generalization aren't needed). The new loop instead repeatedly computes
    the start->goal path, chases the nearest unconfirmed wall on it from
    wherever the robot currently stands, and only travels all the way back
    to start once, right before the final speed run — avoiding the
    back-and-forth cost of the shuttle design while keeping the same
    "resolve only what's needed" search strategy.
    Add sim/, a from-scratch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
    [Maze.c, Maze.h, Move.c, main.c]
2026-07-24 Remove unconditional debug printf calls from the driving hot path
    These were blocking UART sends (115200 baud, byte-by-byte via
    HAL_UART_Transmit in syscalls.c's _write), not gated by any #ifdef, so
    they cost real wall-clock time on every actual run rather than just in
    a debug build:
    - Maze_Dijkstra_Calculation()'s backtrace loop printed one line per
    path hop (~1.1ms/hop at 115200 baud) — for a 50-90 hop path on a
    16x16 maze that's ~56-100ms of blocking delay every time it's
    called, which in the new unknown-wall-search mode happens once per
    discovered wall, right between movement legs with no explicit stop
    in between.
    - Maze_Shortest_Calculation()'s inner retry loops had 12 unco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
2026-07-24 Fix ALL_MODE multi-source BFS seeding in Maze_Step_Calculate
    Maze_Gool_Setting() marks every unexplored cell's step to 0 when
    ALL_MODE is on (return-trip pseudo full-area exploration), but only
    G_Gool_X/Y was ever pushed into the BFS queue, so the other zero-cost
    cells never actually propagated outward. The return trip degenerated
    into a plain shortest-path-to-start map, so it never detoured through
    nearby unexplored cells as intended.
    - Push every cell whose step is actually 0 (not just G_Gool_X/Y) so
    the flood fill runs as true multi-source BFS.
    - Stop special-casing G_Gool_X/Y as an always-first push: while
    ALL_MODE is on, its step is intentionally 100 (not a real source),
    and push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
    [Maze.c]
2026-07-29 Add cascading dead-end filling to skip unreachable-by-shortest-path cells
    A cell whose confirmed walls leave at most one opening can only be
    entered and left through the same edge, so it can never sit on a
    shortest path unless it is an endpoint. During ALL_MODE (pseudo
    full-area exploration on the return trip) Maze_Gool_Setting() seeded
    every unexplored cell as a BFS goal, so the mouse detoured into such
    dead-end pockets for nothing.
    Maze_DeadEnd_Fill() marks those cells in a new G_MAZE_Closed[][] map and
    cascades: once a cell is closed it stops counting as an exit for its
    neighbours, so a whole dead-end corridor collapses back to its root.
    Maze_Gool_Setting() skips closed cells, which also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
    [Maze.c, Maze.h]
2026-07-29 Run the host-side maze test in CI
    Core/Src/Maze.c has no HAL dependency, so it links against host gcc as
    is and test/test_deadend.c can check the dead-end filling invariants on
    every push and pull request. Runs at both MAZE_SIZE=16 and 32, since the
    wall bitmasks and the fill worklist are sized off that constant.
    The test returns non-zero when an invariant breaks, so a regression
    fails the job. Verified against a mutant that drops the start/goal
    protection in Maze_Cell_IsProtected(): 1138 assertion failures, exit 1.
    The firmware's own ARM build is deliberately out of scope here.
    Claude-Session: https://claude.ai/code/session_01S6KGAgx8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
2026-07-29 Protect the whole 2x2 goal square from dead-end filling, and document it
    Maze_Shortest_Calculation() seeds all four cells of
    (G_Gool_X..+1, G_Gool_Y..+1) as terminal, so the goal is a 2x2 square,
    not a single cell. Maze_Cell_IsProtected() only guarded the one cell, so
    the other three could be closed by the cascade. Closing them could not
    corrupt the shortest path - the closed map is never consulted by the
    path search - but it did mean full-area exploration would skip goal
    cells it should still visit, leaving their walls unknown and therefore
    filled in as solid by Maze_Wall_fill(). Guard the whole square.
    The competition goal (MAZE_GOOL_X/Y) is guarded as a square; the start
    and the current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
    [Maze.c]
2026-07-29 Correct the mode reference against main.c
    The mode 0 table claimed No.1 and No.2 end in a shortest run. Neither
    does - both just explore out to the goal, return to the start and save
    the map. Only No.5 and No.6 actually call Short_NANAME_Move2000
    afterwards. No.1's full-area exploration also happens on the return leg,
    not the outbound one.
    Record which numbers actually enable ALL_MODE. Only No.1 and No.4 call
    Maze_Unkown_ALL_ModeSet(); the rest have it commented out. That is also
    exactly where the new dead-end filling can change behaviour, since
    Maze_Gool_Setting() only consults the closed map on its ALL_MODE branch,
    so it is worth stating next to the table.
    Give modes 1 and 3 the real spe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
2026-09-25 Prepare for competition: restore center goal and tidy up
    - Define.h: restore MAZE_GOOL_X/Y to the standard center 2x2 goal
    (MAZE_SIZE/2-1) from the bench-test value (1, 0)
    - main.c: remove the unreachable duplicate `number == 0` branch in mode 5
    - Maze.c: drop the unused `Step` variable in Maze_Shortest_Calculation
    - README: document mode 0 No.7 and replace the bench-settings notes with
    a pre-competition checklist
    Claude-Session: https://claude.ai/code/session_01LqSKccE29MXZ5i9HZi4K9y
    [Define.h, Maze.c, main.c]
2026-09-29 壁センサ値を距離[mm]に変換する仕組みとキャリブレーションモードを追加
    - WallDistance.c: センサ値 -> 距離の表引き+直線補間 (HAL非依存)。
    表は既存定数から1/d^2を仮定して作った仮の値で、実測で置き換える前提
    - モード3 No.4: 100回平均のセンサ値と変換後の距離をCSVで出力する
    キャリブレーションモード
    - calWallConrol(): G_WallCtrl_Use_mm=1 で横壁制御の誤差をmmで計算。
    既定は0で従来と同じ動作
    - test/test_walldist.c とCIジョブで表の単調性・範囲を検査
    Claude-Session: https://claude.ai/cod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
2026-09-29 やることリスト(TODO.md)を追加し、壁センサ距離変換の残作業を記録
    Claude-Session: https://claude.ai/code/session_016UURh3diMHhvpTuQoCqFeZ
2026-09-29 ターンごとに通過速度を変える最短走行(Short_NANAME_MoveTurnV)を追加
    旋回で滑らない速度の上限は旋回半径で決まるのに、既存の最短走行は
    全ターンを同じ速度で回っていた。ターンの種類ごとに通過速度を持ち、
    直線の始点・終点速度を前後のターンに合わせる関数を追加する。
    - Core/Src/SpeedPlan.c: HAL非依存の速度計画。直線の長さで加減速しきれる
    範囲にターン速度を下げ、直結したターンは遅い方にそろえる
    - Move.c: ターンのパラメータ表(Move2000の値が基準、速度に合わせて
    角速度・角加速度を換算)。初期値は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
    [Move.c, Move.h, main.c]
2026-10-05 最短走行の命令列を迷路上で走らせて検査するホストテストを追加
    BFS/ダイクストラで作った G_Short_Pass_NANAME を Move.c と同じ解釈で
    半区画グリッド上に走らせ、壁・柱の通過、実行されない命令の残り、
    ゴール停止、BFS経路のマス数を検査する。
    現時点で見つかっている不具合(修正は別コミット):
    - ダイクストラ経路が同じマスに戻る折り返しを含み、壁に突っ込む(5000迷路中4件)
    - BFS最短がゴール2x2の1マスだけを起点にしているため1〜2マス遠回りになる(約4%)
    Claude-Session: http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
2026-10-05 迷路: ダイクストラ経路の折り返し・BFSの遠回り・最短計算の固まりを修正し、迷路の出力を追加
    - Maze_Dijkstra_Calculation: 境界ノードを通過の向きごとの状態に分けて書き直した。
    向きを持たないノードは、あとから向きが入れ替わると先に古いつながりが残り、
    「マスに入って横へ抜け、同じマスに戻る」走れない経路(壁に突っ込む小回り)を
    作っていた(ランダム迷路5000個中4個)。進めるのは今の向きの先のマスを通る
    3本の辺だけ。ゴールの起点は外向きの向きを持たせた
    - Maze_Shortest_Calculation: ゴール2x2の4マス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
    [Maze.c, Maze.h, main.c]
2026-10-05 最短走行: 経路が空なら走らずにエラーを出す
    スタートからゴールへ行けない迷路(探索が途中で止まった等)では経路が空になるが、
    最短走行の関数はそのまま約1区画前進していた。6つの Short_* 関数すべてで、
    経路を作った直後に空かどうかを確かめ、空なら全LED点滅+低い音を3回鳴らし、
    シリアルに ERROR を出して走らずに戻る。迷路の出力(モード3 No.0)にも NO PATH を出す。
    Claude-Session: https://claude.ai/code/session_01HgF4H4jqYCv5thkfpgnGSz
    [Maze.c, Move.c, UI.c]
2026-10-06 迷路計算の最大時間を実機で測り、迷路の出力に表示する
    探索中は計算のあいだも機体が前の速度のまま進むため、計算が長いと直線が伸びる。
    Maze_Wall_Update / Known_Pass_Generation / Maze_Step_Calculate /
    Maze_Dijkstra_Calculation の最大時間をDWTのサイクルカウンタで記録し、
    モード3 No.0 の出力に TIME_MAX_US として表示する。PCのビルドでは測らない。
    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
2026-10-06 既知区間加速で直線が半区画伸びる不具合を修正
    Known_Pass_Generation() に最短走行用の終端処理(先頭を1にする、終端に1を
    置く)が持ち込まれていた(50195e1)。既知区間は区画の境界の手前から始まるので、
    先頭の1で毎回90mm余分に直進し、終端の1で最後の小回りが大回りになり半区画先で
    終わっていた。モード0 No.6/No.7 で「直線がちょくちょく伸びる」症状の原因。
    元の動作(先頭-1、終端0)に戻した。ランダムな探索状態3000通りで、
    修正後の経路が元のコード(d791164)と一致すること
    (行き止まりUターン-8の修正分を除く)を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
    [Maze.c]
2026-10-06 READMEに既知区間加速の修正と計算時間の表示を追記
    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
2026-10-06 READMEとTODOを実機確認の結果に合わせて更新
    - 実機での確認状況(2026-10-06)の表を追加
    - モード・番号の範囲(0〜15)、何もしない番号、走行後に0/0へ戻ることを追記
    - モード0 No.7の最短走行、既知区間加速の説明を追記
    - 32x32のRAMの古い記述(Short_Dijkstra_Move2000が未接続)を現在のビルドサイズに更新
    - ディレクトリ構成にsim/を追加、大会前チェックに迷路がRAMにしか残らないことを追記
    - 直近の変更を日付ごとに整理
    - TODOにCubeIDEビルド確認済みと、迷路まわりの残りを追加
    Claude-Sessi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
2026-10-06 モード0(探索)の番号を並べ替え、探索の流れを Maze_Search() にまとめる
    新しい並び:
    1 スラローム往復 / 2 スラローム+エセ全面 / 3 スラローム片道
    4 吸引往復 / 5 吸引+エセ全面 / 6 吸引+エセ全面+既知区間加速
    7 ダイクストラ誘導 / 8 ダイクストラ誘導+既知区間加速
    No.0 と No.9〜15 は何もしない。
    7つの分岐にほぼ同じコードが並んでいたのを、main.c の Maze_Search(flags) に
    まとめ、番号ごとに SEARCH_* の組み合わせを指定する形にした。各走り方の
    動作関数・速度・保存の順番は並べ替え前と同じ。探索のあとの最短走行
    (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
2026-10-06 モード0: 吸引+全面+既知区間をやめて詰め、探索→最短の No.8〜10 を追加
    4 吸引往復 / 5 吸引+エセ全面
    6 ダイクストラ誘導 / 7 ダイクストラ誘導+既知区間加速
    8 スラローム往復→最短 / 9 吸引往復→最短
    10 ダイクストラ誘導+既知区間加速→最短
    No.0 と No.11〜15 は何もしない。
    最短は SEARCH_SHORTEST で、スタートに戻ったあと2秒待ってモード1 No.3と
    同じ Short_Dijkstra_Move2000(6000, 20000) を走る(以前のNo.7の最後と同じ手順)。
    READMEの表、TODO、シミュレータのコ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
    [main.c]
2026-10-06 モード1(最短走行)の番号を並べ替え、ダイクストラのコーナー2400を追加
    1 BFS 2000/6000/15000 2 BFS 2000/6000/20000 3 BFS 2400/6000/20000
    4 ダイクストラ 2000/6000/15000 5 同 20000 6 同 23000 7 同 25000
    8 ダイクストラ 2400/6000/20000 9 同 23000
    (コーナー/直線最高速/加速度)。No.0 と No.10〜15 は何もしない。
    10個の分岐に同じコードが並んでいたのを main.c の Maze_Shortest_Run() に
    まとめた。Short_Dijkstra_Move2400 は経路の作り方だけをダイクストラに
    切り替えて Short_NANAME_Move2400 と同じ動きで走る。
    コーナー2700とターンごとの通過速度はモード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
    [Move.c, Move.h, main.c]
2026-10-06 TODOに最短走行の走り出しの加速不足(保留中)を書き残す
    経路がターンで始まると、10mmの台形加速では目標速度に届かず、ターンの手前で
    目標速度がいきなり跳ぶ件と、Motor_Wallcut_STが探索時のG_Wall_dataを使う件、
    直し方の案と実機で測ること。
    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
2026-10-06 吸引探索のゴール後の最初のUターンからログを取る(調査用)
    モード0 No.4(吸引探索 往復)で、ゴール後のUターンのあとに急に速くなる件の調査用。
    Maze_Search() が往路のあとに G_Log_Next_UTurn を1にし、Robot_Maze_Suction_Action()
    のUターン(2つの分岐)で1回だけ LOG_get_start() を呼ぶ。ログは既存の LOG.c
    (1kHzで2秒: 速度の目標と実際、角速度の目標と実際、左右センサ、モーター電圧)で、
    モード4 No.7で出力する。
    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
2026-10-06 Uターンの位置合わせで、壁のない方向に前壁合わせをして急に前進する不具合を修正
    Robot_adjustment() は左90°を2回まわるUターンで、2回目の前壁合わせ(左90°
    回ったあと = 元の左を向いた状態)の判定にも元の「前」の壁の有無を使っていた。
    前が壁で左が空いている区画でUターンすると、何もない方向に向かって
    Motor_Robot_Alignment()(前センサが530になるよう0.5秒駆動)を行い、全力で
    前進して迷路の位置がずれていた(モード0 No.4 のゴール後に発生)。
    - 2回目は元の左の壁(G_Wall_data[1])で判定する
    - 前壁合わせの前に、今の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
    [Move.c]
2026-10-06 READMEとTODOを実機確認の結果に合わせて更新(モード0は全番号OK)
    - 実機での確認状況: モード0 No.1〜10がOK(No.4はUターンの位置合わせの修正後)、
    コーナー2400は走り出しの件があることを追記
    - 直近の変更にUターンの位置合わせの修正を追記
    - TODO: モード0の確認を済みにし、前壁合わせのしきい値の確認を追加
    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
2026-10-06 吸引探索の走り出しの加速度を5000→7000にする
    走り出しの114mmで0→1000mm/sまで加速するが、cos加速で加速度5000だと157mm
    必要で届かず、Motor_trapezoid()は最高速を約930mm/sに下げて約136mm進んで
    から目標速度が1000に跳んでいた(最初の判断位置が約22mm遅れる)。7000なら
    112mmで届く。スラローム探索(500mm/s、5000で39mm)はそのまま。
    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
2026-10-06 ダイクストラ誘導の未知壁探索で、ダイクストラを止まっているときだけ計算する
    以前はゴール到着直後とUターンのあとに、1000mm/sで走りながらダイクストラを
    計算していた(約9ms、その間に約1cm進む)。
    - ゴール到着直後: 次の区画の入口で壁を見たあと区画の中央で止まり、計算してから
    進む向きを決めて発進する(Move.c Robot_Maze_Stop_And_Go / Robot_Maze_Go_From_Stop)
    - Uターン: 吸引探索のUターンと既知区間加速の行き止まりUターン(-8)で、止まって
    いるあいだに G_Stop_Hook の計算を呼ぶ。行き止まりでなければ、計算した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
2026-10-06 壁センサの距離変換: 横(L/R)の表を実測値に置き換える
    モード3 No.4で実測(2026-10-06)。機体の側面を反対側の壁につけ、壁の板(12mm)を
    n枚はさんで、測る側の壁までを 133 - 12n mm(n = 0〜8)にして測った
    (区画の内のり168mm、機体の幅70mm)。
    R: 37mm 780 / 49 522 / 61 356 / 73 262 / 85 201 / 97 160 / 109 131 / 121 110 / 133 93
    L: 37mm 910 / 49 603 / 61 415 / 73 308 / 85 237 / 97 183 / 109 150 / 121 125 / 133 105
    前(FL/FR)はまだ仮の値。test_walldist の点の確認を新しい表に合わせた。
    README、TODOを更新。
    Claude-Session: https://claude.ai/c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
2026-10-06 壁センサの距離変換: 前(FL/FR)の表も実測値に置き換える
    モード3 No.4で実測(2026-10-06)。全長120mm(中心からお尻まで60mm)として、
    お尻を後ろの壁につけ、壁の板(12mm)をn枚はさんで、前の壁までを 108 - 12n mm
    (n = 0〜4)にして測った。
    FL: 60mm 1366 / 72 902 / 84 645 / 96 470 / 108 356
    FR: 60mm 1377 / 72 940 / 84 627 / 96 461 / 108 358
    60mmより近い点と108mmより遠い点はまだ。前壁合わせの目標値530は実測の表では
    前の壁から約92mm(区画中心より約8mm手前)にあたることをTODOに記録。
    test_walldist の点の確認を新しい表に合わせた。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
2026-10-06 壁制御の目標値を実測の区画中心の値に変更する
    2026-10-06の実測の表(WallDistance.c)で区画中心(壁まで84mm)の値は
    L=243、R=206、FL=645、FR=627。
    - 横壁制御 Wall_L/Wall_R: 220/200 → 243/206。以前は片側の壁だけのとき
    左壁から約89mm/右壁から約85mm、両側の壁では中心から右へ約1.7mmずれた
    位置に合わせていた
    - 前壁合わせ FlontWall_Distance: 530 → 636(FL/FRの平均)。以前は前の壁から
    約92mm(区画中心より約8mm手前)で止まっていた
    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
2026-10-06 探索のスラロームで前壁があるときのターン開始位置を前センサの距離で決める
    前センサの遠い点(120〜204mm)を実測して表に追加した。以前の打ち切り値
    (センサ値130)は前壁まで約180mmで、区画の境目(174mm)ではもう超えて
    いたため、前壁があると境目からすぐターンしていた。前壁までが
    174 - 前距離 mm になったところでターンに入るようにした。
    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
2026-10-06 TODO: 探索スラロームの前壁ターンを実機で確認済みにし、前距離・後距離は今の値のままにする
    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
2026-10-06 会場ごとの感度合わせモード(モード3 No.5)を追加
    区画中心で前・左・右のセンサ値を500回平均し、表の区画中心の値との
    倍率(WallDist_Scale)と、倍率を掛けた閾値を、書き写す形でシリアルに出す。
    WallDist_mm() はセンサ値を倍率で割ってから表を引く(既定は倍率1で今までどおり)。
    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
2026-10-07 横壁制御のD項を1msに1回の計算にし、直進中のジャイロ側の符号を固定する
    calWallConrol() は1msに3回呼ばれ、2回目以降はD項が0になっていたため、
    D項が左のPWMにしか効いていなかった。Wall_Control_Update() で1回だけ
    計算し、3か所で同じ値を使う。
    直進中のジャイロ目標の符号を Turn_Mode(直前のターンの向き)で決めていた
    ため、左ターンのあとは壁に寄る向きに効いていた。直進中は常に壁から
    離れる向きにする。
    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
2026-10-07 直進テストを横壁制御の距離版で走るモード4 No.8と、横壁制御のログを追加
    No.8 は No.1 と同じ直進を、そのあいだだけ G_WallCtrl_Use_mm = 1 で走る。
    ログ(モード4 No.7)の最後に、横壁制御の誤差と出力の2列を足した。
    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
2026-10-07 TODO: 32x32ビルドのRAM不足の対策の書き方を直す
    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
2026-10-07 距離版の横壁制御で、遠い壁と壁の切れ目でのキックを抑える
    ログで比べると、距離版は遠い壁や壁の切れ目でセンサ値版の約2倍の出力が
    出ていた。距離版だけ、104mmより遠い壁を使わない、片側の誤差を±20mmで
    頭打ち、切れ目の判定を1msの変化25に、壁の有無が切り替わった瞬間は
    D項を出さない、とした。センサ値版は変えていない。
    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
2026-10-07 横壁制御を距離版を標準にし、モード4 No.8 をセンサ値版の比較用にする
    対策後の直進テストのログで、距離版の方が角速度の振れが小さかった
    (最大 +67/-85°/s、センサ値版は +175/-118°/s)。
    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
2026-10-07 TODO: 距離版の横壁制御で探索・最短走行を実機確認済みにする
    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
2026-10-07 TODO: 横壁制御の見直しの項目を整理する
    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
2026-10-07 最短走行の走り出しを、スタート区画の境目までのなめらかな加速にまとめる
    最初がターンの経路では10mmで0→Vに加速しようとして届かず、目標速度が
    Vへ跳んでいた(2400で約1800→2400)。Short_Start() で、スタート位置から
    区画の境目まで(114mm)で0→Vにcos加速する。加速度は π V²/(4×114)。
    最初が直線ならその半区画ぶんを走ったことにし、ターンなら境目から
    Motor_Wallcut_ST で曲がる。1000・2000・2400・2700・ダイクストラ2000に適用。
    Claude-Session: https://claude.ai/code/session_01HgF4H4jqYCv5thkfp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
    [Move.c]
2026-10-07 README: 走り出しの件を修正済み・実機未確認にする
    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
2026-10-07 最初がターンの走り出しを元に戻す(前回の変更の誤り)
    最初がターンの経路では、スタート位置から24mmで区画中心、そこから
    ターンの前距離・ターン・後距離になる。前回の変更は114mm加速してから
    曲がっていたので、ターンに入るのが遅れる。最初がターンの側は以前の
    動きに戻し、最初が直線の側のなめらかな加速だけ残す。
    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
2026-10-07 最短走行で最初がターンの経路は、最初のターンを1500で曲がり後距離で加速する
    スタートから24mm+前距離では最高速まで加速できないので、最初のターンだけ
    1000のターン(前距離・角度・後距離)を速度1500に合わせて曲がる
    (最大角速度×k、角加速度×k²、k=v1/1000)。前距離までに0→1500、後距離で
    1500→最高速へ、どちらも加速度40000でcos加速する(加速しながら壁の切れ目を
    見る Motor_Wallcut_*_Accel を追加)。次の直線は後距離の終わりの速度から加速する。
    大回り90/180・斜め入り45/135に対応。右斜め入り45は1500に届かない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
2026-10-07 最初のターンの前後の加速度を40000から50000にする
    全パターンで前距離までに1500に届く(右斜め入り45も約1580まで出せる)。
    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
2026-10-07 最初のターンの間のログを取る(斜め入り135で壁に当たった件の調査用)
    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
2026-10-07 最初がターンの経路で180°回っていた不具合を直す
    圧縮で0になった直線は -1(飛ばす)として残るので、最初がターンの経路では
    先頭が -1 になり、ターンは2番目以降にある。Short_Start が先頭の -1 を
    ターンとして読み、どれにも当てはまらず大回り180として曲がっていた。
    先頭の -1 を飛ばして読み、知らない命令では曲がらないようにした。
    次の直線を後距離の終わりの速度から始める処理も、-1 では持ち越すようにした。
    test_shortpath に最初の命令の形の確認を追加。
    Claude-Se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
    [Move.c]
2026-10-07 最短走行の最初のターンを調整するモード(モード4 No.9〜No.11)を追加
    最初のターンのパラメータを G_First_Turn(1500のときの前距離・角度・
    最大角速度・角加速度・後距離)の表にまとめ、Short_First_Turn_Run() で
    単体でも走れるようにした。No.9: 右大回り90、No.10: 右斜め入り45、
    No.11: 右斜め入り135。スタート位置から最初のターンを走り、後距離で
    2400へ加速して、そのまま減速して止まる。動きは変えていない。
    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
    [Move.c, Move.h, main.c]
2026-10-07 最初のターンの調整値と会場ごとの壁センサ倍率を実機の値にする
2026-10-07 最初のターンの直後の直線は、最高速に届くまで加速度50000で加速する
    2400で最初が斜め入り135(後距離の終わり約1660)、その後の斜めの直線が
    1区間だけのとき、斜めの直線の加速度(10000〜13000)では約2090〜2210まで
    しか戻れず、次のターンで目標速度が跳んでいた。直後の直線だけ、最高速に
    届くまでの区間を加速度50000で走り、残りはいつもどおり走る。
    最初のターンの直後以外の直線は今までと同じ。
    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
2026-10-07 test_walldist: 会場ごとの倍率に関係なく表そのものを確かめる
    WallDist_Scale を会場の値(1.01, 0.99, 1.02, 1.06)に書き換えたため、
    倍率1を前提にした表の確認が失敗していた。テストの最初で倍率を1にして
    表を確かめ、書き写した倍率は0.5〜2倍の範囲かだけを確かめる。
    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
2026-10-07 最初のターンの速度をターンごとにし、後距離のうちに2400まで上がりきるようにする
    最初のターンのすぐ後がまたターンの経路は、ランダム迷路で約8割あった。
    次の区間に頼らないように、G_First_Turn に速度の列を足し、後距離の
    うちに2400まで加速しきれる速度にした(大回り90: 1500、斜め入り45: 1570、
    斜め入り135: 1900)。斜め入り45・135の角速度・角加速度は1500の調整値から
    軌跡の形が同じになるように換算した(要再調整)。
    Claude-Session: https://claude.ai/code/session_01HgF4H4jqYCv5thkfpg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
2026-10-07 docs: 他の人のターンごとの速度・前後距離・速度のつなぎ方の調査メモを追加
    Claude-Session: https://claude.ai/code/session_015hspvHYJsPwukXa1Uo3r7j
2026-10-07 ターンごとの通過速度を2400基準に作り直し、連続ターンは後距離で次のターンの速度へ変える
    - TurnV_Table を Short_NANAME_Move2400 のパラメータ基準にし、初期値を
    V90 2200、斜め入り45/135・斜め出135 2400、大回り90 2600、大回り180 2500、斜め出45 2600 にした
    - SpeedPlan: ターンが直結するとき、前のターンの後距離(8割)で加速度30000で次のターンの速度へ変える。
    変えきれなければ速い方を下げる(従来の遅い方にそろえる動きは turn_back なしで残す)
    - motor.c: Accel_Target_Update を減速にも対応させ、後距離の加速版を減速にも使えるよ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
    [Move.c, Move.h, main.c, motor.c]
2026-10-07 TODO/README: 2026-10-07時点の状態に整理する
    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
2026-10-08 最初のターンの大回り90を実機で調整した値にする
    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
2026-10-08 最初のターンの加速度を実機で出せる25000にし、ターンの速度を届く値に換算する
    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
2026-10-08 最初のターンの斜め入り45・135を実機で調整した値にする
    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
2026-10-08 最短走行の最初のターンのあいだだけ吸引を70に上げる
    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
2026-10-08 TODO/README: 最初がターンの経路が2000・2400とも走ったことを記録
    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
2026-10-08 最初のターンのすぐ後がターンのとき、そのターンの前距離で加速して目標速度を跳ばさない
    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
2026-10-08 次のターンの前距離で加速する変更を取り消す(最初のターンの中で完結させる方針のため)
    This reverts commit 1505814.
    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
    [Move.c, motor.c, motor.h]
2026-10-08 TODO: 2026-10-08 の続き(斜め入り45の寄り、斜めの調子が悪い件)を記録
    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
2026-10-09 加速しながら曲がる最初のターンを追加(モード4 No.12〜14で試せる、既定は今までどおり)
    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
2026-10-09 2000の最短走行は最初のターン専用の動きを使わず、以前の走り出しに戻す
    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
2026-10-09 距離版の横壁制御の比例ゲイン Kp_mm を 0.26 から 0.35 にする
    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
2026-10-09 モード4 No.1 をタイヤ径の測定用(吸引70、最大1000でゆっくり1440mm)にする
    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
2026-10-09 タイヤ径を実測の23.1mmにする
2026-10-09 2000のターンの値を1つの表(G_Turn2000、BFSの値)にまとめ、BFS・ダイクストラ・モード6で共通にする
    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
2026-10-09 探索の既知区間加速で大回りを使わず、曲がりはすべて小回りスラロームで走る
    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
2026-10-09 距離版の横壁制御の微分ゲイン Kd_mm を 0.05 から 0.07 にする
    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
2026-10-09 モード6の斜め出45・斜め出135・V90を斜めスタートに戻す
    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
2026-10-10 2000のターン(斜め入り・斜め出・V90)の調整値と会場ごとの壁センサ倍率を実機の値にする
2026-10-10 ダイクストラ2000の区画の直線をBFSと同じ減速2倍の台形(Asymmetric)にする
    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
2026-10-10 最短走行の斜めの直線の加速度を変えられるようにする(モード1は番号ごとに ac_nn で指定)
    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
2026-10-10 2400とターンごとの最短の斜めの直線の加速度を、直線の加速度-5000にする
    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
2026-10-10 距離版の横壁制御で横センサの直近3回の中央値を使い、1回だけの落ち込みを消す
    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
2026-10-10 距離版の横壁制御で壁の切れ目判定が効くようにし、使う壁の距離を120mmまでにする
    Sensor_diff_L/R は g_sensor[i][1] がずらし後に [0] と同じ値なので常に0で、
    切れ目判定が一度も効いていなかった。距離版では横センサの直近3回の中央値どうしの
    1msの差で判定する。センサ値版の判定は変えていない。
    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
2026-10-10 距離版の横壁制御で、一定距離進む間に距離が大きく変わった壁を使わず、低速でのゲインに下限を付ける
    壁の見え始め・消えかけはセンサ値が20mmほどかけて変わり、その途中で壁を遠いと読んで
    誤差が±20に張り付き、ジャイロが40〜60deg/s振れていた。1msの変化での判定は速度で
    効き方が変わり1000mm/sでは効かなかったので、10mm進む前の距離と比べて8mm以上
    変わった壁は使わない。減速中にゲインが小さくなり片寄っていたので、倍率の下限を0.5にする。
    Claude-Session: https://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
2026-10-10 区画中心で測った値から、横センサ R・L の距離の倍率を合わせる
    モード3 No.4 で区画中心が L=242→82.0mm、R=198→89.5mm と左右で7.5mm食い違って
    いたので、R・L とも84mmになるよう 1.07・0.95 から 0.96・1.00 にする。
    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
2026-10-10 README: 倍率の変更の記録を 2026-10-10 の欄に移す
    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
2026-10-10 README: 改行コードを元に戻す
    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
2026-10-10 最短走行の壁切れを、壁の有無に関係なく柱の切れ目で見られるようにする
    main.c の Short_WallCut_Pillar を1にすると、最短走行の間だけ G_WallCut_Pillar が立ち、
    横センサの値が Pillar_Len(5mm)進む間に Pillar_TH(40)以上減ったところを柱の後ろの端と
    みなして壁切れする。区画の境目には必ず柱があるので、壁のない所でも壁切れできる。
    既定は0で従来どおり。探索中はいつも従来どおり。
    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
    [Wallsensor.c, Wallsensor.h, main.c, motor.c, motor.h]
2026-10-10 斜めの壁切れは柱版でも従来どおりにする
    Cut_L_NA / Cut_R_NA を使う斜めの壁切れ(斜めの前距離・後距離、加速版、最初のターン)を
    柱版にする前のコードに戻し、Pillar_TH_NA を消す。
    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
2026-10-10 距離版の横壁制御をセンサ値版と同じ強さにし、ノイズで壁が切り替わらないようにする
    センサ値版のほうがふらつきが少なかったので、Kp_mm 0.35→0.30、Kd_mm 0.07→0.06
    (区画中心付近の約6[値/mm]で、センサ値版の Kp=0.05・Kd=0.01 と同じ効き)にする。
    左センサのノイズで壁を使う/使わないが数msおきに切り替わっていたので
    WallCtrl_mm_StableTH を 8→15mm にし、比べるため WallCtrl_mm_GainMin を 0 にする。
    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
2026-10-10 柱版の壁切れでも、壁があるときは従来どおりセンサ値が閾値を下回ったら壁切れする
    壁がないときだけ柱の切れ目で見る。壁の有無は待ち始めの時点の G_Wall_data で決める
    (1msごとに更新され、壁が終わると0になるため、待っている間に柱の判定に変わらないように)。
    壁がある所は従来と同じ位置で反応するので、前距離・後距離はそのまま使える。
    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
2026-10-11 READMEを整理し、モード選択を先頭にまとめる
    モード選択(選び方・モード一覧・各モード)を先頭に移し、よく変える設定の表と
    壁切れ(柱)の説明を足した。モード6 No.0(直進)、モード4 No.5・No.8・No.12〜14、
    モード1の斜めの加速度、横壁制御の距離版の説明を今のコードに合わせた。
    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
2026-10-11 TODO: 九州地区大会(10-25)までの2週間の予定を足す
    Claude-Session: https://claude.ai/code/session_01U3wJFNXc7KPsPT1UjKketk
2026-10-11 TODO: 大会までの優先順を、壁制御の安定化と壁切れの2つにする
    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
2026-10-11 docs: 壁制御と壁切れのほかの人のやり方を調べてまとめる
    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
2026-10-12 柱の壁切れを走った距離ごとの履歴で比べ、壁切れの位置のテストを足す
    - DistHist: センサ値を走行距離1mmごとに残す履歴(HAL非依存、test_disthist.cでCI)
    - G_Odo_X: 動作ごとに0に戻らない走行距離
    - Pillar_Edge: G_Pillar_DistHist=1 でちょうど Pillar_Len 前と比べる(以前は速度で3〜6mmと変わっていた)
    - G_WallCut_Fast: 壁ありの壁切れを3回の中央値で見るスイッチ(既定0で従来どおり)
    - モード3 No.6〜9: 壁切れの位置のテスト(500/1000/2000/2400)
    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
2026-10-12 docs: 柱の壁切れの設計をまとめる
    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
2026-10-12 docs: 横センサの向き(区画中心で柱の真ん中を見る、約47°)を柱の壁切れの設計に入れる
    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
2026-10-12 柱の壁切れを設計どおりに作り直す(段階1)
    - 柱の端の検出(PillarEdge.c、HAL非依存): 直前30mmの最大値の半分を切った位置。
    センサ値ができた時点(DMA割り込み)の走行距離で記録し、中央値とLPFの遅れを戻す
    - 境目の推定: 端の位置 + Edge_Off + 横のずれの補正(Edge_Tan)。左右にあれば平均
    - 前距離(柱のとき): 区画中心 + X を、前・後ろの境目の実測で直す。後距離は距離だけ
    - 午前の「5mmで40減ったら」の判定(Pillar_Edge など)はなくす
    - モード3 No.6〜9: 柱の端と境目の推定を出す。モード4 No.15: 最短走行の壁切れのログ
    - test_pill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
2026-10-12 ビューア(tools/viewer.html)を足し、ロボットの出力の形をそろえる
    - ブラウザ(Chrome/Edge)でUSBシリアルを直接読み、走行ログのグラフ、壁切れのテスト・
    最短走行の壁切れの表と図、迷路、感度合わせを表示する。ネットは使わない
    - 保存先フォルダ(logs/)に、届いたデータを1つずつ自動で保存する
    - 走行ログ・壁切れ・迷路・感度合わせの出力を #BEGIN 種類 ... / #END 種類 ではさむ。
    走行ログは取った行数だけ、桁を減らして出す
    Claude-Session: https://claude.ai/code/session_01U3wJFNXc7KPsPT1U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
2026-10-12 誤って入れたビューアの確認用の画像を消す
    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
2026-10-12 壁切れのテストで横センサの値を1mmごとに残し、ビューアでグラフにする
    - モード3 No.6〜9: sig,x,右,左 の行(3回の中央値、最大1000mm)を出す
    - ビューア: 横センサの値と距離のグラフ(区画の境目・見つけた柱の端を重ねる)と、
    c-border と速度の点のグラフ(左右別)を足す
    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
2026-10-12 走行ログを目的から選び直す
    - 列: 走った距離、速度・目標、角速度・目標、角度、横センサ、横の壁までの距離、使った壁、
    横壁の誤差・P項・D項、電圧、電池、動作(phase)。int16で持ちRAMを約8KB減らす
    - G_Log_Div: 普段は1msおき(2秒)、最短走行は4msおき(8秒)。最短走行は走り始めから取る
    - 各動作の関数で G_Log_Phase を立てる
    - ビューア: 動作で背景を色分け、横軸を時間/走った距離で切り替え、動作で絞った値の表
    - 設計は docs/log_design.md
    Claude-Session: https://claude.ai/code/session_01U3w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
2026-10-12 出力をモード4 No.7のひとつにまとめる
    迷路(以前はモード3 No.0)、壁切れのログ(以前はモード4 No.15、テストは走ったあとすぐ出していた)、
    走行ログを、RAMに残っているものだけ順に出す。ビューアが種類ごとに分ける。
    壁切れのテストの区画の境目と速度は、ログを始めるときに残しておく。
    main.c に stdio.h を入れる(printf の暗黙の宣言の警告がなくなる)
    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
2026-10-12 従来の壁切れの前距離も、壁切れのログに前距離の始めと曲がり始めを残す
    - Cut_ST_Conv で st / st_cut を残す(src 16: 壁切れした、32: 曲がる側に壁がなく距離だけ)。
    ビューアの前距離の表が従来のときも埋まり、柱のときと並べて比べられる
    - Motor_Wallcut_ST で走行ログの phase を「前距離」にするのが柱のときだけになっていたのを直す
    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
2026-10-12 READMEを整理する
    - 使い方(動かし方、大会での流れ、モード、出力とビューア、設定、実機での確認状況)を中心に並べ直し、目次を付けた
    - 詳しい設計・テストの中身・変更の記録を docs/ に移した(changelog.md、maze_algorithm.md、
    turnv_design.md、testing.md、pillar_cut_design.md の付録)。中身はそのまま
    - なくしたモード4 No.15 の記述、古いRAMの数字、実機での確認状況(2026-10-07時点のまま)を今に合わせた
    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
2026-10-12 ビューアを速くする
    - グラフ本体(軸・線・帯・点)を範囲と大きさが変わったときだけ描いて取っておき、
    指したときは縦線とドラッグの範囲だけ重ねる(1回 約4ms → 約0.3ms)。指した位置の描き直しは描画のたびに1回
    - 受け取った文字をまとめて行に分ける(毎回残りの文字列を作り直していた)
    - ファイルの読み込みや、出力が続けて届いたときは、最後に1回だけ描く
    (約0.9MBの読み込み 188ms → 約10ms、シリアル 151ms → 約23ms)
    Claude-Session: https://claude.ai/code/session_01U3wJFNXc7KPsPT1Uj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
2026-10-12 ビューア: センサの値を出し続けるモードに対応する
    - 感度合わせ(モード3 No.5)は1秒ごとに一覧とファイルが増え続けていた。続けて届いたら
    いちばん新しい値に置き換え、自動では保存しない(5秒あくと新しい測定として足す)
    - センサ表示(モード4 No.0)と距離の表(モード3 No.4)の行を読み取り、直近10秒を流れるグラフと今の値を出す
    「センサの値(そのまま)」を足した。まとめて届いた行は時刻を等間隔に並べる。止める・CSVで保存
    - 「ぜんぶ保存」用に覚えておく文字に上限(最後の約10MB)を付けた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
2026-10-12 ビューア: 拡大を戻すボタンと Esc キーを足す
    拡大しているあいだだけ「拡大を元に戻す(Esc)」を出す(走行ログ、壁切れのテストのセンサ値、
    最短走行の壁切れの図)。Esc キーでも、表示しているグラフ全部を戻す。ダブルクリックも今までどおり
    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
2026-10-12 TODO を整理する(大会までの順番に並べ直す)
    - 予定の表に状態を足し、次に実機でやること(10-13)を先頭にまとめた
    - 第1 壁制御、第2 壁切れ、第3 大会で走らせるもの(探索と2000の最短)、大会前、大会のあと に分けた。
    開いている項目は全部残し、2400の最初のターン・ターンごとの通過速度・柱の段階2以降は「大会のあと」へ
    - ビューアでの見方を各項目に書いた。古くなっていた記述(Kp の値の重複、RAMの数字)を直した
    - 記録に 2026-10-12 を足した
    - 今日の変更の日付を 2026-10-13 と書いていたのを 2026-10-12 に直した(READM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
2026-10-12 吸引のときのセンサのノイズを測るテストを追加する(モード3 No.10)
    止まったまま、吸引(0/35/50/70)とセンサの読み方(LEDを点けてから読むまでの待ち 0/30us、
    ADCの取り込み時間 3/56サイクル)を変えて、点灯時・消灯時の生の値と差のばらつきを測る。
    読み終えたときの吸引のPWMの位置も残す。読み方を変えるのはテストのあいだだけ。
    ビューアで表・グラフ・PWMの位置との散布図にする(NOISE)。
    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
2026-10-13 未知壁探索で、見に行った壁が実際にあったら止まって壁合わせをし、ダイクストラを計算し直す
    ダイクストラ誘導の未知壁探索(モード0 No.6・No.7・No.10)は、2026-07-24に計算回数を
    減らしてから、ゴール到達直後とUターンのときしか経路を計算し直さず、ふさがれた古い
    経路の残りの壁を確認して終わることがあった。東北大会(No.7)では下回り55区画・上回り
    57区画の迷路で下回りを確認せずに上回りを走った(写真から読み取った迷路で再現)。
    見に行った壁があったときは、次の区画の中央で止まり、前壁があれば壁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
2026-10-13 TODO: 探索の直進に壁切れの距離補正を入れる案を書いておく(第2のあと)
    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
2026-10-17 MK3 の Fusion 360 データ(f3z)を追加
    Claude-Session: https://claude.ai/code/session_0156Q4g8mrzo4MjueC94bbUc
2026-10-17 MK3 全体v2 の STEP を追加
    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
2026-10-17 STEPから読んだ寸法(トレッド・ギア・慣性モーメント)を記録
    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
