Tokoro0917/KOGUMA.MkIIl/(notices)

Notices in the files:
KOGUMA.MkII/Core/Inc/main.h:
Copyright (c) 2025 STMicroelectronics.
All rights reserved.
This software is licensed under terms that can be found in the LICENSE file
